catuta0/tpu-e-cpu/reports/fpga/soc/soc_impl.md

# SoC implementation report — soc_top on Tang Nano 9K (task RTL-SOC)

Agent: fpga-engineer · Date: 2026-11-04 · Input revision: ac0f0a0-dirty (spec rev C, ARCHITECTURE.md 12 / INTERFACES.json revision C)
Command (reproducible): `bash scripts/synth_soc.sh` (both flows, 3 seeds each, ~45 min single-thread);
`REPORT_ONLY=1 bash scripts/synth_soc.sh` rebuilds the tables/pins/pack from the logs.
Tools: Yosys 0.70 (YoWASP), nextpnr-0.11.1 himbaechel-gowin (YoWASP), Apicula 0.32 (gowin_pack).
Device GW1NR-LV9QN88PC6/I5, `--vopt family=GW1N-9C`, CST `design/constraints/tangnano9k.cst`, `--freq 27`,
`--threads 1`, **no** `--timing-allow-fail`. Logs: `logs/soc/synth_<flow>.log`, `logs/soc/pnr_<flow>_s<seed>.log`.

**Label: every number below is SIMULATION (tool estimate of synthesis / static timing), not a
hardware measurement. Passing P&R is not hardware validation; the nextpnr Gowin timing model is not
validated against silicon. The bitstream was never programmed into a device.**

## Design synthesised
`design/rtl/soc/soc_top.v` = rv32i_core (design/rtl/cpu, unchanged) + soc_bus + soc_ram (4 KiB, INIT
`sim/data/soc_demo_prog.hex`) + soc_periph (LED, UART TX 234 clk/bit, CYCLE, TOHOST) + sc_tpu (NL 16, IL 8,
RNG_MODE 2, rev C seeds, INIT `sim/data/weights.hex`, `bias.hex`, `input.hex`), 2-FF reset synchroniser,
active-low LED inversion. Ports exactly INTERFACES.json `top_ports`.

Yosys cell list, chosen flow (`synth_gowin -nowidelut`, logs/soc/synth_nwl.log `stat`):
LUT1 12, LUT2 518, LUT3 1486, LUT4 1508, ALU 1642, DFF 235, DFFE 1088, DFFR 117, DFFRE 1119, DFFS 2, DFFSE 146,
RAM16SDP4 16, SDPX9B 3, SPX9 2, IBUF 3, OBUF 7. Yosys `check`: "Found and reported 0 problems" (4 x, both
flows), 0 latches inferred (REQ-TIM-002).

BSRAM mapping (routed netlist, logs/soc/bsram_init.log): 5 blocks = soc_ram 2 x SP (4 KiB program/data,
non-zero INIT = program image), sc_tpu weight RAM 1 x SDP (non-zero INIT = weights.hex), CPU register file
2 x SDP (all-zero INIT, cleared by the CPU CLEAR state). INPUT/BIAS buffers: 16 RAM16SDP4 (LUT RAM, as in
RTL-TPU). DSP blocks: 0 (REQ-RES-003).

## Utilisation and timing per flow (from the nextpnr "Device utilisation" block and the LAST "Max frequency" line)
<!-- generated by scripts/synth_soc.sh from logs/soc/, input revision ac0f0a0-dirty -->

### Flow `nwl`: synth_gowin -nowidelut (chosen)

| Resource | device total | 85 % limit | seed 1 | seed 2 | seed 3 | worst % | <= 85 % |
|---|---|---|---|---|---|---|---|
| LUT4 | 8640 | 7344 | 5628 (65 %) | 5628 (65 %) | 5628 (65 %) | 65 % | PASS |
| ALU | 6480 | 5508 | 1976 (30 %) | 1976 (30 %) | 1976 (30 %) | 30 % | PASS |
| DFF | 6480 | 5508 | 2803 (43 %) | 2803 (43 %) | 2803 (43 %) | 43 % | PASS |
| BSRAM | 26 | 22 | 5 (19 %) | 5 (19 %) | 5 (19 %) | 19 % | PASS |
| RAM16SDP4 | 270 | 229 | 16 (5 %) | 16 (5 %) | 16 (5 %) | 5 % | PASS |
| IOB | 276 | 234 | 10 (3 %) | 10 (3 %) | 10 (3 %) | 3 % | PASS |
| MUX2_LUT5 | 4320 | 3672 | 0 (0 %) | 0 (0 %) | 0 (0 %) | 0 % | PASS |
| MULT18X18 | 20 | 17 | 0 (0 %) | 0 (0 %) | 0 (0 %) | 0 % | PASS |

(nextpnr counts every ALU cell inside LUT4 as well; LUT4 is the total of logic positions used.)

| Seed | P&R exit | post-route Fmax (MHz) | margin vs 27 MHz | >= 29.7 MHz |
|---|---|---|---|---|
| 1 | 0 | 51.98 | +92.5 % | PASS |
| 2 | 0 | 47.46 | +75.8 % | PASS |
| 3 | 0 | 51.21 | +89.7 % | PASS |

Worst seed 2: 47.46 MHz (clock `u_bus.clk`); worst utilisation of any resource 65 %.

### Flow `def`: synth_gowin default wide-LUT (comparison)

| Resource | device total | 85 % limit | seed 1 | seed 2 | seed 3 | worst % | <= 85 % |
|---|---|---|---|---|---|---|---|
| LUT4 | 8640 | 7344 | 6130 (70 %) | 6130 (70 %) | 6130 (70 %) | 70 % | PASS |
| ALU | 6480 | 5508 | 1976 (30 %) | 1976 (30 %) | 1976 (30 %) | 30 % | PASS |
| DFF | 6480 | 5508 | 2803 (43 %) | 2803 (43 %) | 2803 (43 %) | 43 % | PASS |
| BSRAM | 26 | 22 | 5 (19 %) | 5 (19 %) | 5 (19 %) | 19 % | PASS |
| RAM16SDP4 | 270 | 229 | 16 (5 %) | 16 (5 %) | 16 (5 %) | 5 % | PASS |
| IOB | 276 | 234 | 10 (3 %) | 10 (3 %) | 10 (3 %) | 3 % | PASS |
| MUX2_LUT5 | 4320 | 3672 | 710 (16 %) | 710 (16 %) | 710 (16 %) | 16 % | PASS |
| MUX2_LUT6 | 2160 | 1836 | 138 (6 %) | 138 (6 %) | 138 (6 %) | 6 % | PASS |
| MUX2_LUT7 | 1080 | 918 | 49 (4 %) | 49 (4 %) | 49 (4 %) | 4 % | PASS |
| MUX2_LUT8 | 1080 | 918 | 18 (1 %) | 18 (1 %) | 18 (1 %) | 1 % | PASS |
| MULT18X18 | 20 | 17 | 0 (0 %) | 0 (0 %) | 0 (0 %) | 0 % | PASS |

(nextpnr counts every ALU cell inside LUT4 as well; LUT4 is the total of logic positions used.)

| Seed | P&R exit | post-route Fmax (MHz) | margin vs 27 MHz | >= 29.7 MHz |
|---|---|---|---|---|
| 1 | 0 | 46.47 | +72.1 % | PASS |
| 2 | 0 | 45.79 | +69.6 % | PASS |
| 3 | 0 | 42.8 | +58.5 % | PASS |

Worst seed 3: 42.8 MHz (clock `u_bus.clk`); worst utilisation of any resource 70 %.

### Acceptance (ARCHITECTURE.md 10: each resource <= 85 %, worst-seed Fmax >= 29.7 MHz)
| Item | Chosen flow `nwl` | Result |
|---|---|---|
| Worst resource utilisation | 65 % (LUT4 5628 / 8640) | PASS (<= 85 %) |
| DFF | 2803 / 6480 = 43 % | PASS |
| BSRAM | 5 / 26 = 19 % | PASS |
| IOB | 10 / 276 (all 10 top-level IOs) | PASS (REQ-RES-005: 10) |
| DSP (MULT*) | 0 | PASS |
| Worst-seed post-route Fmax | 47.46 MHz (seed 2); seeds 51.98 / 47.46 / 51.21 | PASS (>= 29.7 MHz; +75.8 % vs 27 MHz, +59.8 % vs 29.7 MHz, CALCULATION) |

Flow comparison (CALCULATION from the tables): `-nowidelut` uses 502 fewer LUT4 positions (5628 vs 6130),
no MUX2_LUTx cells (vs 915) and its worst seed is 4.66 MHz faster (47.46 vs 42.80 MHz). `-nowidelut` is kept.
Against the stand-alone blocks: TPU IL8 mode 2 nwl 4572 LUT4 / 2669 DFF (RTL-TPU) + CPU in-context 957 LUT4 /
126 DFF (RTL-CPU) = 5529 / 2795; the SoC is 5628 / 2803, i.e. +99 LUT4 / +8 DFF for bus, peripherals and UART
(CALCULATION; the CPU number included its own small wrapper, so this is approximate).

## Critical path (chosen flow, worst seed 2, post-route) — reports/fpga/soc/critical_path_nwl.txt
21.07 ns = 8.83 ns logic + 12.24 ns routing (=> 47.46 MHz). Inside the CPU: instruction register
`u_cpu.ir` -> decoder / FSM next-state logic (`u_cpu.state`) -> ALU operand select -> 32-bit ALU carry chain
(`u_cpu.alu_q` ALU cells) -> program-counter register (`cpu_dbg_pc` = pc, D input). This is the same class of
path as in RTL-CPU (ir -> decoder -> FSM, 18.77 ns there); the TPU datapath (53-77 MHz alone) is not critical
in the SoC. The default flow's worst path (seed 3, 23.36 ns = 9.73 + 13.63) is the same CPU path ending on the
pc clock enable (critical_path_def.txt). The 10 % margin target needs <= 33.67 ns; slack 12.6 ns.

## Pin placement (worst seed 2 of `nwl`, scripts/pnr_pin_report.py, logs/soc/pins.log)
| Port | Bel | IO | Package pin | IO standard |
|---|---|---|---|---|
| clk | X46Y16/IOBA | IOR17A (GCLKT_3) | 52 | LVCMOS33, pull-up |
| btn_rst_n | X1Y0/IOBA | IOT2A | 3 | LVCMOS18, pull-up |
| led_n[0..5] | X0Y14..X0Y25 | IOL15A, IOL16B, IOL21B, IOL22B, IOL25B, IOL26B | 10, 11, 13, 14, 15, 16 | LVCMOS18 |
| uart_tx | X1Y28/IOBA | IOB2A | 17 | LVCMOS33, pull-up |
| uart_rx | X1Y28/IOBB | IOB2B | 18 | LVCMOS33, pull-up |

All 10 ports placed on the CST pins (script checks every pin, `NIO = 10`). The only "not found" Infos in the
P&R logs are the documented spare `btn_s2_n` and the 26 GW1NR in-package PSRAM pins. uart_rx is unused
(INTERFACES.json) and kept by a `(* keep *)` net so that its IOB and constraint remain.

## Bitstream (route proof only — NEVER programmed)
`gowin_pack -d GW1N-9C -o sim/soc/build/soc_top.fs sim/soc/build/soc_top_nwl_pnr_s2.json` -> PACK_EXIT=0,
3 556 680 bytes (uncompressed ASCII .fs; larger than the 2.07 MB smoke bitstream because the BSRAM init data is
included), sha256 `152d3c6dada6338e0b98a8fc19557ec95f4e40479e4f264411c72caa85b76258` (logs/soc/pack.log).
The file is a build product (sim/soc/build/, gitignored); rebuild with `bash scripts/synth_soc.sh`.

## Not done / limits
- Gate-level (post-synthesis / post-route) simulation: NOT RUN (no behavioural Gowin BSRAM models in
  yowasp-yosys; see RTL-CPU lesson).
- Hardware test: NOT RUN (no hardware programming in this project).
- Timing is single-corner nextpnr STA of the Gowin chip database; no I/O timing constraints (the only
  external interfaces are a button, LEDs and a 115200 Bd UART, all asynchronous / slow).
