catuta0/tpu-e-cpu/management/RESUME.md

# Resume
To resume after a restart: `claude --continue`, then run the engineering-project
skill again; it reads this file. Named agents in .claude/agents/ will then load
natively (see ADR-000).
Current position: see PROJECT_STATE.md and TASK_BOARD.md.
