catuta0/tpu-e-cpu/reports/article/main.tex

% =============================================================================
% DOC-02 -- Scientific article, revision for design rev C (IEEEtran conference).
% Project: SC-TPU + RV32I SoC on the Sipeed Tang Nano 9K (GW1NR-9).
% Author of this file: documentation-engineer.
% Input revision: git fab802e (branch claude/awesome-lovelace-hu02o8); HEAD moved
% to 99ee941 during the task, which changes only management/EXECUTION_METRICS.md
% and scripts/make_release.sh (no evidence file).  Design state: spec rev C
% (design/architecture/ARCHITECTURE.md sec. 12, management/INTERFACES.json
% revision C, management/DECISIONS.md ADR-008..012).
% History: DOC-01 (rev A draft, input eee3352) -> DOC-02 (this file, rev C).
%
% Build:  cd reports/article && latexmk -pdf -interaction=nonstopmode \
%                                        -halt-on-error main.tex
% Figures: vector PDFs generated by reports/figures/article_figures.py from
%          reports/sw/accuracy_revC.json and reports/sw/revABC_comparison.json
%          (log: logs/doc/article_figures_revC.log); block/timing diagrams are
%          TikZ (this file).
%
% Number policy (CLAUDE.md, engineering-evidence skill):
%   * every number carries a "% evidence: <path>" comment on or next to its line;
%   * labels used in the text: SIMULATION, CALCULATION, SOURCE, ASSUMPTION;
%     no MEASUREMENT exists in this project (no hardware was operated);
%   * synthesis / place-and-route / static-timing numbers are tool estimates
%     and are labelled SIMULATION in the project sense.
%
% REVIEW HOOK: the independent review (reports/review/REVIEW_A_cpu_soc.md,
% reports/review/REVIEW_B_tpu_model_article.md, task REV-01) was running when
% this revision was written.  Its findings are NOT reflected yet; search for
% "REVIEW-FINDINGS-HOOK" below for the place where they are to be summarised.
% =============================================================================
\documentclass[conference]{IEEEtran}

\usepackage[T1]{fontenc}
\usepackage{amsmath,amssymb}
\usepackage{graphicx}
\usepackage{cite}
\usepackage{booktabs}
\usepackage{multirow}
\usepackage{xcolor}
\usepackage{tikz}
\usetikzlibrary{positioning,arrows.meta,calc,fit,decorations.pathreplacing}
\usepackage{url}
\usepackage[hidelinks]{hyperref}

% Figures generated by scripts in reports/figures/.
\graphicspath{{../figures/}}

% -----------------------------------------------------------------------------
% Placeholder macro kept from DOC-01 for future use (prints a red [TBD:name]).
% DOC-02 filled every numeric placeholder; it is no longer used in the text.
% -----------------------------------------------------------------------------
\newcommand{\TBD}[1]{\textcolor{red}{\textbf{[TBD:\detokenize{#1}]}}}

% Small helpers for consistent notation.
\newcommand{\Dp}{D'}                 % post-processed accumulator (spec: Dp)
\newcommand{\NL}{N_{L}}              % neuron lanes
\newcommand{\IL}{N_{I}}              % input lanes
\newcommand{\lbl}[1]{\textsc{#1}}    % evidence label in running text

\begin{document}

\title{A Stochastic-Computing Tensor Unit and an RV32I Core on a 9K-LUT FPGA:\\
Bit-Exact Co-Design for Tiny-MLP Inference}

% Author names and affiliation have not been provided by the user: placeholders.
\author{\IEEEauthorblockN{Author Name}
\IEEEauthorblockA{Affiliation (placeholder)}}

\maketitle

% =============================================================================
\begin{abstract}
Stochastic computing (SC) replaces a multiplier by a single logic gate acting
on random bit-streams, which makes it attractive for the smallest FPGAs, where
dedicated multipliers are scarce. We present the co-design of an SC tensor
processing unit (SC-TPU) and a multi-cycle RV32I processor for an 8640-LUT4
Gowin GW1NR-9 device (Sipeed Tang Nano 9K). The SC-TPU is a 16$\times$8
weight-stationary tile of bipolar XNOR multipliers with accumulative parallel
counters, driven by 8-step leap-forward LFSRs. Its behaviour, including the
random-number sequence and the integer post-processing, is specified
bit-exactly, so that a Python golden model, the training flow and the RTL must
agree bit for bit; in simulation they do on 1454 inferences. For a 64-16-10 MLP
on the 8$\times$8 digits set the golden model gives 95.0\,\% test accuracy for
the expected-value datapath and 94.4\,\% (95\,\% CI 91.6--96.4\,\%) for SC with
independent per-lane generators at stream length 256 (92.8$\pm$1.4\,\% over 20
seed offsets). A seed revision that maximised the phase spacing of the
generators made the operand-pair streams of different lanes time-translates
of each other and lost 4.7 percentage points at stream length 512 (McNemar
$p=0.0015$); we derive two seed rules that exclude this and select seeds on
validation data. The integrated SoC uses 65\,\% of the LUT4 positions and
closes timing at 47.46\,MHz (worst of three seeds) against the 27\,MHz board
clock; one inference takes 2928 cycles (108\,\textmu s). All results are
simulations with an open-source flow; a bitstream was generated but never
loaded into a device.
% evidence: logs/tpu/sim_tpu_console.log (1454 golden inferences = 474+506+474, 0 mismatching fields)
% evidence: reports/sw/accuracy_revC.json (EV 342/360; mode2 K8 340/360 CI 91.6-96.4; ensemble mean 92.8 sd 1.4, n_realisations 20)
% evidence: reports/sw/revABC_comparison.md sec. 2 (C vs B, K=9: +4.7 pp, McNemar exact p = 0.00151)
% evidence: reports/fpga/soc/soc_impl.md (LUT4 5628/8640 = 65 %, worst seed 47.46 MHz); logs/soc/tb_soc_demo.log (D6 CYCLES 2928)
% evidence: requirements/BUDGETS.md sec. 3 (2928 cycles = 108.44 us at 27 MHz, CALCULATION); logs/soc/pack.log (bitstream, never programmed)
\end{abstract}

\begin{IEEEkeywords}
stochastic computing, neural network accelerator, RISC-V, FPGA, LFSR seeding,
bit-exact golden model, open-source FPGA toolchain
\end{IEEEkeywords}

% =============================================================================
\section{Introduction}
\label{sec:intro}

Low-cost FPGAs with fewer than ten thousand look-up tables are widely used in
education, prototyping and small embedded products, but they offer only a
handful of hard multipliers. The GW1NR-9 device used here has 8640 LUT4
positions, 6480 flip-flops, 26 block RAMs and 20 18$\times$18
multipliers~\cite{sipeed_tn9k}.
% evidence: management/SOURCES.md S-001, S-002, S-005, S-010 (SOURCE, Sipeed wiki D-09 + chip database D-20)
A binary int8 neural-network datapath on such a device is limited to at most
40 hard 9$\times$9 multiply--accumulate (MAC) lanes, or must spend roughly 70
LUTs per soft 8$\times$8 multiplier (rough \lbl{calculation}).
% evidence: management/DECISIONS.md ADR-001 option B (~70 LUT soft multiplier, rough CALCULATION); management/SOURCES.md S-032 (40 MULT9X9, SOURCE D-20)

Stochastic computing~\cite{gaines1969,alaghi2013survey} encodes a number as the
probability of a one in a random bit-stream. A multiplication then reduces to
a single AND (unipolar) or XNOR (bipolar) gate, and the precision becomes a
run-time parameter: doubling the stream length $L$ halves the variance of the
result. Neural networks tolerate moderate arithmetic noise, which has made them
a prominent application of SC~\cite{brown2001stochastic,%
kim2016dynamic,ren2017scdcnn}. The price is latency ($L$ clock cycles per
product), the cost of random-number generation, and a sensitivity to
correlation between streams.

A second, less discussed difficulty is \emph{verification}: an SC result is a
random variable, so a hardware/software comparison is meaningless unless the
random sequence is defined as precisely as the arithmetic. This paper treats
the random-number generators, their seeding and their sequencing as part of a
bit-exact architectural contract, and shows that the seeds themselves are a
design parameter that needs its own rules and its own held-out evaluation.

\textbf{Contributions.}
\begin{enumerate}
\item A complete, small SoC for the Tang Nano 9K: a multi-cycle
  RV32I CPU~\cite{riscv2019unpriv} orchestrating a 16$\times$8 weight-stationary
  bipolar SC tile with accumulative parallel counters (APC), implemented with
  an open-source flow~\cite{shah2019yosysnextpnr,yosys,apicula}
  (Section~\ref{sec:arch}).
\item A bit-exact specification of the SC datapath (8-step leap-forward LFSR,
  three RNG decorrelation modes, integer post-processing), mirrored by a
  Python golden model used for noise-aware training and matched by the RTL
  in simulation (Section~\ref{sec:method}).
\item An accuracy study versus stream length and RNG mode with confidence
  intervals and a 20-offset seed ensemble, and an analytical variance model
  checked against simulation (Section~\ref{sec:results}).
\item A documented design iteration on the LFSR seeds, including a negative
  result: phase-maximal seeds are \emph{worse}; two seed rules and a
  pre-registered selection protocol replace them (Section~\ref{sec:iteration}).
\end{enumerate}

% =============================================================================
\section{Background and Related Work}
\label{sec:background}

\subsection{Stochastic number encoding}
A stochastic number (SN) is a bit-stream $b_0,\dots,b_{L-1}$. In
\emph{unipolar} encoding it represents $p=P(b_k{=}1)\in[0,1]$; in
\emph{bipolar} encoding it represents $v = 2p-1 \in[-1,1]$, which admits signed
weights with a single stream per operand~\cite{gaines1969,alaghi2013survey}.
A stochastic number generator (SNG) converts a binary code $c$ into a stream by
comparing it with a pseudo-random number $r$: $b=[r<c]$. With $r$ uniform on
$\{0,\dots,2^n-1\}$, $P(b{=}1)=c/2^n$.

\subsection{Multiplication and accumulation}
For two independent unipolar streams the AND gate gives $P(a\wedge b)=p_ap_b$.
For bipolar streams the XNOR gate gives
\begin{equation}
  P\big(\overline{a\oplus b}=1\big) = \tfrac{1}{2}\left(1 + v_a v_b\right),
  \label{eq:xnor}
\end{equation}
i.e.\ the bipolar product~\cite{brown2001stochastic,alaghi2013survey}.
Accumulating many products with a multiplexer scales the sum down by the fan-in
and loses precision. An accumulative parallel counter instead counts the ones
of all product streams in each cycle and adds the count to a binary
accumulator, so the sum is exact in expectation and leaves the stochastic
domain; SC-DCNN~\cite{ren2017scdcnn} studied such APC-based inner products for
deep convolutional networks. Kim \emph{et al.}~\cite{kim2016dynamic} exploited
the stream length as a run-time energy--accuracy knob in deep networks.

\subsection{Precision, correlation and LFSRs}
An $L$-bit estimate of $p$ has variance $p(1-p)/L$, so every factor of four in
$L$ adds one bit of precision. Equation~\eqref{eq:xnor} holds only for
independent streams; streams generated from the same or from shifted random
sequences are correlated and bias or inflate the error~\cite{alaghi2013survey}.
Linear-feedback shift registers (LFSRs) are the usual cheap random source.
Taking $n$ consecutive bits of a single-step LFSR as $r$ yields successive
values that are shifted copies of each other, and two LFSRs with the same
polynomial produce lagged copies of the same maximal-length sequence. Both
effects matter in a small design that cannot afford many independent
generators.

\subsection{Small RISC-V cores and open FPGA flows}
PicoRV32~\cite{wolf_picorv32} is a size-optimised RV32 core with the same
native valid/ready memory interface that we adopt. The Yosys and nextpnr
tools~\cite{shah2019yosysnextpnr,yosys}, together with the reverse-engineered
Gowin database of Project Apicula~\cite{apicula}, provide a fully open flow for
the GW1N family; we use it exclusively.

% =============================================================================
\section{Architecture}
\label{sec:arch}

\subsection{SoC overview}
Fig.~\ref{fig:soc} shows the SoC. A single 27\,MHz clock domain is driven by
the board oscillator (no PLL); the reset button passes through a two-flip-flop
synchroniser into a synchronous active-high reset.
% evidence: design/architecture/ARCHITECTURE.md sec. 2; management/INTERFACES.json "clock"
The CPU is the only bus master. Slaves are selected by address bits [31:28]
(Table~\ref{tab:memmap}); an access to an unmapped region returns zero,
completes normally and sets a sticky debug flag, so a software error can never
hang the bus. The bus is a native valid/ready protocol: the master holds
\texttt{mem\_valid}, address, data and byte strobes stable until the slave
returns a one-cycle \texttt{mem\_ready} pulse. RAM and peripherals answer in
the second cycle, the SC-TPU in the third; a TPU read of its buffers while the
controller owns their ports waits for up to 35 cycles (\lbl{simulation}).
% evidence: design/architecture/ARCHITECTURE.md sec. 3, 4; management/handoffs/fpga-engineer/RTL-SOC.md (design summary: 1 wait state RAM/periph, TPU 3rd cycle); RTL-TPU.md (longest valid->ready 35 cycles); management/DECISIONS.md ADR-012 (<= 40 cycles allowed)

\begin{figure}[!t]
\centering
\begin{tikzpicture}[
    font=\scriptsize,
    blk/.style={draw, thick, rounded corners=1pt, align=center,
                minimum height=0.8cm, inner sep=2pt},
    sub/.style={draw, align=center, minimum height=0.62cm, inner sep=1.5pt,
                minimum width=1.75cm},
    >={Stealth[length=1.5mm]}]
  % ---- CPU (only bus master) -------------------------------------------
  \node[blk, minimum width=2.2cm] (cpu) at (1.1,0.35)
       {RV32I multi-cycle\\CPU (FSM)};
  \node[draw, align=center, minimum width=2.2cm, inner sep=1.5pt,
        below=0.05cm of cpu] (rf) {regfile in 2 BSRAM};
  \draw[<-] (cpu.north) -- ++(0,0.3) node[above]
       {27\,MHz clk, rst (2-FF sync)};
  % ---- Bus ----------------------------------------------------------------
  \draw[line width=1.6pt] (2.7,1.2) -- (2.7,-1.75);
  \node[anchor=south west, font=\tiny, inner sep=1pt] at (2.7,1.2) {valid/ready bus};
  \draw[<->, thick] (cpu.east) -- (2.7,0.35);
  % ---- RAM and peripherals ---------------------------------------------
  \node[blk, minimum width=2.75cm, anchor=west] (ram) at (3.1,0.8)
       {RAM 4\,KiB (BSRAM)\quad\texttt{0x0}};
  \node[blk, minimum width=2.75cm, anchor=west] (per) at (3.1,-0.3)
       {LED, UART TX, CYCLE,\\TOHOST \texttt{0x1000\_0000}};
  \draw[<->, thick] (2.7,0.8) -- (ram.west);
  \draw[<->, thick] (2.7,-0.3) -- (per.west);
  \draw[->] (per.east) -- ++(0.3,0) node[right, align=left]
       {6 LEDs\\UART TX};
  % ---- SC-TPU -------------------------------------------------------------
  \draw[thick, dashed, rounded corners=2pt] (-0.05,-1.2) rectangle (7.2,-3.95);
  \node[anchor=south east, font=\scriptsize\bfseries, align=right] at (7.15,-3.9)
       {SC-TPU\\\texttt{0x2000\_0000}};
  \node[sub, anchor=west] (regs) at (3.1,-1.75)
       {CTRL, STATUS,\\CONFIG, PARAMS};
  \node[sub, anchor=west] (bufs) at (5.1,-2.65)
       {INPUT, HIDDEN,\\SCORE, BIAS};
  \node[sub, anchor=west] (wram) at (3.1,-2.65)
       {weight RAM\\2\,KiB BSRAM};
  \node[sub, anchor=west] (ctl) at (3.1,-3.5)
       {controller FSM\\tile/layer counters};
  \draw[<->, thick] (2.7,-1.75) -- (regs.west);
  \node[sub, anchor=west] (lfsr) at (0.1,-1.75) {16 LFSRs, 8-step leap\\(RNG mode 2)};
  \node[sub, anchor=west, fill=black!7, minimum height=0.75cm] (arr)
       at (0.1,-2.65) {16$\times$8 SC tile\\XNOR + APC};
  \node[sub, anchor=west] (pp) at (0.1,-3.5) {post-processing\\+ argmax};
  \draw[->] (lfsr) -- (arr);
  \draw[->] (arr) -- (pp);
  \draw[->] (wram.west) -- node[above, font=\tiny]{tile load} (arr.east);
  \draw[->] (pp.east) -- (ctl.west);
\end{tikzpicture}
\caption{SoC block diagram (architecture specification rev~C). The CPU is the
only bus master; the SC-TPU is a memory-mapped slave whose weight RAM is
time-shared between CPU accesses and tile loads.}
\label{fig:soc}
\end{figure}

\begin{table}[!t]
\centering
\caption{Memory map (spec rev C, \lbl{source}: architecture specification)}
\label{tab:memmap}
% evidence: design/architecture/ARCHITECTURE.md sec. 4, 4.1, 5.4; management/INTERFACES.json revision C
\footnotesize
\setlength{\tabcolsep}{2.2pt}
\begin{tabular}{@{}lll@{}}
\toprule
Base & Size & Content \\
\midrule
\texttt{0x0000\_0000} & 4\,KiB & RAM (program + data), reset PC $=0$ \\
\texttt{0x1000\_0000} & 32\,B & LED, UART\_TX/STATUS, CYCLE, TOHOST \\
\texttt{0x2000\_0000} & 4\,KiB & SC-TPU: registers \texttt{0x000}--\texttt{0x017}, \\
 & & INPUT \texttt{0x040}, SCORE \texttt{0x080}, HIDDEN \texttt{0x0C0}, \\
 & & BIAS \texttt{0x100}, weight RAM \texttt{0x800}--\texttt{0xFFF} \\
other & -- & read 0, write ignored, sticky \texttt{bus\_err} \\
\bottomrule
\end{tabular}
\end{table}

\subsection{RV32I multi-cycle CPU}
The CPU implements the RV32I base instruction set~\cite{riscv2019unpriv} with
FENCE as a no-op; there are no CSRs and no interrupts. ECALL, EBREAK, illegal
encodings (strictly decoded, including all CSR instructions, unknown
funct3/funct7 values, \texttt{0x00000000} and \texttt{0xFFFFFFFF}) and
misaligned accesses or jump targets halt the core with one of six trap
causes. Because the CPU only orchestrates the accelerator, it is optimised for
area:
% evidence: design/architecture/ARCHITECTURE.md sec. 6, 9; management/DECISIONS.md ADR-004, ADR-006
\begin{itemize}
\item a state machine with the states CLEAR, FETCH, DECODE, EXECUTE,
  SHIFT or MEM, and WB; CLEAR zeroes the 32 registers once after reset
  (32 cycles), so the first fetch follows 31 cycles after reset release
  (\lbl{simulation});
\item the register file is held in two block RAMs (one per read port), costing
  no LUT or flip-flop for its 1\,kbit of state;
\item a single 33-bit adder serves arithmetic, comparisons and address
  generation; branch targets are computed in DECODE so that the comparison in
  EXECUTE can reuse it;
\item shifts are iterative (4 or 1 bit per cycle) instead of a barrel shifter.
\end{itemize}
% evidence: management/handoffs/fpga-engineer/RTL-SOC.md (tb_soc R5: first fetch 31 cycles after rst falls); management/DECISIONS.md ADR-011
The resulting cycles per instruction at zero wait states are
(\lbl{calculation} from the FSM): 3 for LUI, AUIPC, JAL, FENCE and branches,
4 for ALU operations, JALR and stores, 5 for loads, and
$4+\lfloor n/4\rfloor+(n \bmod 4)$ for a shift by $n$.
% evidence: management/handoffs/fpga-engineer/RTL-CPU.md (micro-architecture summary); design/rtl/cpu/rv32i_core.v header

\subsection{SC-TPU dataflow}
The workload is a 64-16-10 multilayer perceptron with a clipped-ReLU hidden
layer and an argmax output. Every input, activation and weight is an 8-bit
code $c$ representing the bipolar value $v(c)=(c-128)/128\in[-1,127/128]$.
% evidence: design/architecture/ARCHITECTURE.md sec. 5.1, 5.2
The array is a weight-stationary tile of $\NL=16$ neuron lanes by $\IL=8$ input
lanes (Fig.~\ref{fig:tile}). $\NL=16$ equals the hidden width, so one pass of
a layer-1 tile serves all hidden neurons. Layer~1 is processed in
$T=64/8=8$ tiles and layer~2 in $T=16/8=2$ tiles; the six unused neuron lanes
of layer~2 are padding and are ignored by the argmax.
% evidence: design/architecture/ARCHITECTURE.md sec. 5.3, 5.5; management/DECISIONS.md ADR-002
A fully parallel layer-1 array (1024 lanes, 8192 weight flip-flops) does not
fit the 6480 flip-flops of the device, which fixed the tile choice.
% evidence: management/DECISIONS.md ADR-002 (CALCULATION); management/SOURCES.md S-002

For one tile the 128 weights $W_{ji}$ and the 8 input codes $x_i$ are loaded
into registers; then, during $L=2^K$ stream cycles $k$, every neuron lane
updates its APC accumulator
\begin{equation}
  \mathit{acc}_j \leftarrow \mathit{acc}_j + \sum_{i=0}^{\IL-1}
  \overline{[r_x(i,k)<x_i] \oplus [r_w(j,i,k)<W_{ji}]} .
  \label{eq:acc}
\end{equation}
The accumulators are cleared once per layer and keep running over its tiles,
so after the last tile $\mathit{acc}_j$ is the count of ones of the complete
dot product.
% evidence: design/architecture/ARCHITECTURE.md sec. 5.3 step 1a-1b

\begin{figure}[!t]
\centering
\begin{tikzpicture}[
    font=\scriptsize,
    box/.style={draw, align=center, minimum height=0.5cm, inner sep=1.5pt},
    gate/.style={draw, circle, inner sep=0.5pt, minimum size=0.45cm},
    >={Stealth[length=1.4mm]}]
  % Random number sources
  \node[box, minimum width=1.25cm] (lx) at (-0.2,0.9) {LFSR$_{X,i}$\\16b, 8 steps};
  \node[box, minimum width=1.25cm] (lw) at (-0.2,-0.9) {LFSR$_{W,i}$\\16b, 8 steps};
  % Comparators of lane (j,i)
  \node[box] (cx) at (2.2,0.9) {$r_x<x_i$};
  \node[box] (cw) at (2.2,-0.9) {$r_w<W_{ji}$};
  \node[box, minimum width=0.9cm] (xr) at (2.2,1.75) {$x_i$ reg};
  \node[box, minimum width=0.9cm] (wr) at (2.2,-1.75) {$W_{ji}$ reg};
  \draw[->] (lx) -- node[above]{$r_x$ (8b)} (cx);
  \draw[->] (lw) -- node[below]{$r_w$ (8b)} (cw);
  \draw[->] (xr) -- (cx);
  \draw[->] (wr) -- (cw);
  % XNOR
  \node[gate] (xn) at (3.55,0) {$\overline{\oplus}$};
  \draw[->] (cx.east) -| (xn.north);
  \draw[->] (cw.east) -| (xn.south);
  % Popcount and accumulator
  \node[box, minimum width=1.15cm, minimum height=1.1cm] (pc) at (4.85,0)
       {popcount\\over $\IL{=}8$\\lanes};
  \draw[->] (xn) -- node[above]{$p_{ji}$} (pc);
  \node[font=\tiny, align=center] at (4.85,-0.85) {7 other lanes\\of neuron $j$};
  \draw[->] (4.85,-0.65) -- (pc.south);
  \node[box, minimum width=0.95cm, minimum height=1.1cm] (acc) at (6.4,0)
       {$+$\\$\mathit{acc}_j$\\17b};
  \draw[->] (pc) -- node[above]{0..8} (acc);
  \draw[->] (acc.east) -- ++(0.35,0) node[right, align=left]{post-\\proc};
  % Replication brace
  \draw[decorate, decoration={brace, amplitude=3pt}]
       (1.55,2.15) -- (4.1,2.15) node[midway, above=2pt]
       {one MAC lane $(j,i)$, replicated $16\times 8$};
\end{tikzpicture}
\caption{One MAC lane of the SC tile and the APC of neuron $j$. The input
comparator $[r_x<x_i]$ is shared by the 16 neuron lanes; every weight has its
own comparator. In the default RNG mode 2 each input lane $i$ has its own
LFSR pair, shared by the 16 neuron lanes; modes 0/1 use one pair for all lanes.}
\label{fig:tile}
\end{figure}

\subsection{Leap-forward LFSR and RNG modes}
All generators are 16-bit Fibonacci LFSRs with the polynomial
$x^{16}+x^{14}+x^{13}+x^{11}+1$ (period 65535, maximal, \lbl{calculation}).
% evidence: design/architecture/ARCHITECTURE.md sec. 5.3; requirements/BUDGETS.md sec. 9.1 (scripts/budgets/logs/lfsr_check.log)
To avoid the shifted-copy correlation of consecutive single-step outputs, each
stream cycle advances every LFSR by \emph{eight} steps and uses the low byte of
the new state as $r$ (ADR-005). Each of the eight new bits is the XOR of four
current-state bits, so the leap costs eight LUT4s and one logic level per LFSR
(\lbl{calculation}); the RTL registers the state one stream cycle ahead, so
$r$ is a flip-flop output.
% evidence: requirements/BUDGETS.md sec. 1.2 (8-step leap-forward); management/DECISIONS.md ADR-005; management/handoffs/fpga-engineer/RTL-TPU.md (look-ahead LFSR)
The golden model verifies the unrolled network against eight single steps for
all 65536 states, and the RTL testbench does so for 70\,000 cycles.
% evidence: management/handoffs/software-engineer/SW-01a.md (test_leap8_equals_8_single_steps_for_all_states); logs/tpu/tb_sc_lfsr8.log ("TC2 LEAP==8x1 70000 cycles, 0 mismatches")

Three RNG modes are a synthesis parameter (ADR-003):
\begin{itemize}
\item \emph{Mode 0 (shared)}: one LFSR$_X$ (seed \texttt{0xACE1}) for all
  input lanes and one LFSR$_W$ (seed \texttt{0xF9DE}, half a period later)
  for all weight lanes.
\item \emph{Mode 1 (rotate)}: the same two LFSRs, lane $i$ uses
  $\mathrm{rotl}_8(r,i)$, a free re-wiring.
\item \emph{Mode 2 (independent, default)}: one LFSR pair per input lane,
  seeds $(\texttt{0xACE1}+\texttt{0x3C5A}\,i)\bmod 2^{16}$ and
  $(\texttt{0x7A5C}+\texttt{0x2B67}\,i)\bmod 2^{16}$, shared by the 16 neuron
  lanes.
\end{itemize}
% evidence: design/architecture/ARCHITECTURE.md sec. 12 (rev C seeds; 0xF9DE = S(32768)); management/INTERFACES.json revision C tpu.lfsr
The LFSRs are loaded with their seeds when START is accepted, advance only in
stream cycles and are not reset between tiles or layers. In the RTL, mode 2
costs 111 LUT4 and 224 flip-flops (14 additional 16-bit LFSRs) more than mode~1
(\lbl{simulation} of synthesis and place-and-route). Mode~1 was the default of
the first specification (rev~A); rev~C makes mode~2 the default, with the
seeds chosen as described in Section~\ref{sec:iteration}.
% evidence: reports/fpga/tpu/variants.md (il8_m1_nwl 4461 / 2445 vs il8_m2_nwl 4572 / 2669: +111 LUT4, +224 DFF); management/DECISIONS.md ADR-003, ADR-008, ADR-010

\subsection{Post-processing (bit-exact)}
After the last tile of a layer each neuron $j$ is post-processed with integer
arithmetic exactly as in the specification, with $N_{in}$
the layer fan-in, $K\in\{4,\dots,10\}$ and the activation shift
$s\in\{0,\dots,7\}$:
\begin{align}
  D_j &= 2\,\mathit{acc}_j - N_{in}L, \label{eq:D}\\
  B_j &= \left\lfloor \mathit{bias}_j\, 2^K / 128 \right\rfloor,
  \qquad \Dp_j = D_j + B_j, \label{eq:B}\\
  u_j &= \left\lfloor \Dp_j\, 2^{s+7} / 2^K \right\rfloor, \nonumber\\
  \mathrm{HIDDEN}_j &= 128 + \mathrm{clip}(u_j,0,127), \label{eq:hidden}\\
  \mathrm{SCORE}_j &= \Dp_j \;\text{(signed, 32 bits)}, \label{eq:score}
\end{align}
where \eqref{eq:hidden} applies to layer~1 (hidden codes),
\eqref{eq:score} to layer~2, $\mathit{bias}_j$ is a signed 16-bit integer in
units of $1/128$, and
$\mathrm{RESULT}=\arg\max_{j\in\{0..9\}}\mathrm{SCORE}_j$ with ties resolved to
the lowest index. Since $E[\overline{a\oplus b}]=(1+v_av_b)/2$,
$\Dp_j/L$ is an unbiased estimate of $\sum_i v(x_i)v(W_{ji})+\mathit{bias}_j/128$
up to the floor in $B_j$.
% evidence: design/architecture/ARCHITECTURE.md sec. 5.3 (post-process, interpretation)
The RTL uses a 17-bit accumulator, 20-bit signed $D$, $B$ and $\Dp$, and a
34-bit exact shifter for $\Dp\,2^{s+7}$, in a two-stage pipeline
(\lbl{calculation}, checked on 53\,328 directed vectors in simulation).
% evidence: management/handoffs/fpga-engineer/RTL-TPU.md (widths; tb_sc_postproc "vectors checked = 53328, mismatches = 0"); requirements/BUDGETS.md sec. 1.3

\subsection{Programming model and tile schedule}
Weights and biases are written once through the bus into the weight RAM and the
BIAS buffer (or pre-loaded from initialisation files in the bitstream). Per
inference the CPU writes the 64 input codes (16 words), sets LOG2\_L and
ACT\_SHIFT in CONFIG, writes START, polls STATUS.DONE and reads RESULT; the
CYCLES register reports the busy time.
% evidence: design/architecture/ARCHITECTURE.md sec. 5.4, 5.6, 8
Fig.~\ref{fig:timing} shows the tile schedule of the RTL controller. A tile
load reads the 32 weight words from the block RAM in 32 consecutive cycles
plus one cycle of read latency; the two input words are read in the same
cycles. $L$ stream cycles follow. After the last tile of a layer, 19 cycles
($\NL+3$) read the biases, run the two-stage post-processing pipeline and
update the argmax on the fly.
% evidence: design/rtl/tpu/sc_tpu_ctrl.v header (FSM S_LOAD NWT+1 = 33, S_STREAM 2^K, S_POST NL+3 = 19)

\begin{figure}[!t]
\centering
\resizebox{\columnwidth}{!}{%
\begin{tikzpicture}[font=\scriptsize, >={Stealth[length=1.3mm]},
    seg/.style={draw, minimum height=0.36cm, inner sep=0pt, anchor=west,
                align=center}]
  % Signal names
  \foreach \y/\n in {0/state, -0.6/wram\_rd, -1.2/stream\_en, -1.8/acc\_clr}
    \node[anchor=east] at (-0.1,\y) {\texttt{\n}};
  % State bar (not to scale)
  \node[seg, minimum width=1.5cm, fill=black!8, font=\tiny] at (0,0) {LOAD W+X};
  \node[seg, minimum width=2.6cm, font=\tiny] at (1.5,0) {STREAM ($L=2^K$)};
  \node[seg, minimum width=1.0cm, fill=black!8, font=\tiny] at (4.1,0) {LOAD};
  \node[seg, minimum width=0.6cm, font=\tiny] at (5.1,0) {\dots};
  \node[seg, minimum width=1.1cm, fill=black!15, font=\tiny] at (5.7,0) {POST};
  % wram_rd high during LOAD
  \draw (0,-0.75) -- (0,-0.45) -- (1.5,-0.45) -- (1.5,-0.75) -- (4.1,-0.75)
        -- (4.1,-0.45) -- (5.1,-0.45) -- (5.1,-0.75) -- (6.8,-0.75);
  % stream_en high during STREAM (LFSR advance + APC accumulate)
  \draw (0,-1.35) -- (1.5,-1.35) -- (1.5,-1.05) -- (4.1,-1.05)
        -- (4.1,-1.35) -- (5.1,-1.35) -- (5.1,-1.05) -- (5.7,-1.05)
        -- (5.7,-1.35) -- (6.8,-1.35);
  % acc_clr pulse at layer start (tile 0, first load cycle)
  \draw (-0.0,-1.95) -- (0,-1.65) -- (0.15,-1.65) -- (0.15,-1.95) -- (6.8,-1.95);
  % Durations
  \draw[<->] (0,-2.35) -- node[below]{$32{+}1$} (1.5,-2.35);
  \draw[<->] (1.5,-2.35) -- node[below]{$2^K$} (4.1,-2.35);
  \draw[<->] (5.7,-2.35) -- node[below]{$\NL{+}3=19$} (6.8,-2.35);
  \node[anchor=west, align=left] at (0,-2.95)
       {tile $t$ \hspace{3.1cm} tile $t{+}1$ \dots\ last tile, then layer post-processing};
\end{tikzpicture}}
\caption{Tile schedule of the RTL controller (durations in clock cycles; not
to scale). The LFSRs advance only while \texttt{stream\_en} is high. Ten tiles
and two post-processing phases give $\mathrm{CYCLES}=10(2^K+33)+2\cdot19$
(\lbl{calculation}, confirmed by \lbl{simulation} for $K=4..10$).}
% evidence: design/rtl/tpu/sc_tpu_ctrl.v header; logs/tpu/tb_sc_tpu_mode2.log (D8 "CYCLES = 2928 = measured BUSY cycles 2928 = formula 10*2^8+368"); management/handoffs/fpga-engineer/RTL-TPU.md (TPU-014 every K)
\label{fig:timing}
\end{figure}

% =============================================================================
\section{Co-Design and Verification Methodology}
\label{sec:method}

\subsection{Bit-exact golden model}
The Python golden model implements the specification twice: a literal
reference with explicit loops and eight single LFSR steps per stream cycle,
and a vectorised engine that pre-computes, per tile and lane, a count table
from the histogram of $(r_x,r_w)$ pairs, which makes the accuracy sweeps fast.
All 593 exported test vectors (33 fields each: hidden codes, scores, result)
were regenerated by the slow reference with 0 mismatches
(\lbl{simulation}); 158 unit tests pass.
% evidence: logs/sw/gen_hex.log ("CROSSCHECK TOTAL: 593 vectors x 33 fields, mismatches = 0"); logs/sw/pytest_revC.log ("158 passed")
For the RTL the model exports, per RNG mode, the 360 test images at $K=8$,
51 corner-case parameter sets, 63 sweep vectors ($K=4..10$,
$s\in\{0,3,7\}$) and cycle-by-cycle RNG traces. Every vector file carries a
specification-revision header that the simulation scripts check. The RTL
testbench compares all hidden codes, scores, RESULT and CYCLES of 1454
inferences over the three modes, plus 239 re-runs with out-of-range LOG2\_L
values, with 0 mismatching fields, and the per-lane random numbers of the
first 64 stream cycles after every START with 0 mismatches
(\lbl{simulation}, Icarus Verilog 12.0~\cite{icarus}).
% evidence: logs/tpu/sim_tpu_console.log (mode 2: "golden vectors total 474 (+69 clamp re-runs), mismatching inferences 0, mismatching fields 0"; R1/R2 RNG trace 0 mismatches; spec_rev guard); management/handoffs/fpga-engineer/RTL-SOC.md (1454 + 239, rev C)

\subsection{Training with SC noise}
The data set is the 8$\times$8 handwritten-digits set distributed with
scikit-learn~\cite{pedregosa2011sklearn,uci_digits} (1797 images, pixels
0..16). A stratified split gives 1437 training and 360 test images; 288 of the
training images form a validation split used for every model choice and for
the seed selection, and the test split is used only for the final numbers.
Pixels map to codes $c=128+\lfloor(127p+8)/16\rfloor$, i.e.\ non-negative
bipolar values.
% evidence: reports/sw/accuracy_revC.json "split", "dataset"; code/python/sctpu/train.py pixel_to_code
Three variants were trained (Adam, 300 epochs, straight-through estimator for
the code rounding): \emph{float} (rounded after training), \emph{qat}
(quantisation-aware) and \emph{qat\_noise}, which adds zero-mean Gaussian noise
with the independent-stream variance of~\eqref{eq:var3} at $K=8$ to both
layers' pre-activations during training. The selected model is qat\_noise with
$s=0$, chosen on the validation split; the final weights were then re-trained
on all 1437 training images. The network was not re-trained for the later
seed revisions.
% evidence: management/handoffs/software-engineer/SW-01a.md (assumptions, selected model); SW-03.md ("Not retrained"; caveat: re-trained on all 1437 training images); reports/sw/accuracy_revC.json selected_variant, selected_s, retrained = False

\subsection{Analytical error model}
Writing each stream bit as a spin $\sigma=2b-1$ and assuming uniform,
cycle-independent $r$ and independent X and W generators, the variance of the
estimate $\Dp/L$ of one neuron is (\lbl{calculation})
\begin{equation}
  \mathrm{Var}\!\left(\frac{\Dp}{L}\right) = \frac{1}{L}\sum_{\text{tiles}}
  \Big[\sum_{i,k} C^{x}_{ik} C^{w}_{ik} - \Big(\sum_i v_{x,i} v_{w,i}\Big)^2\Big],
  \label{eq:var2}
\end{equation}
where $C_{ik}$ is the spin correlation of lanes $i$ and $k$ within a tile
($C_{ii}=1$). With shared numbers (mode 0) $C_{ik}=1-2|a-b|/256$ for codes $a,b$;
mode 1 is enumerated exactly over the 256 values of $r$; for independent lanes
(mode 2) it reduces to
\begin{equation}
  \mathrm{Var}\!\left(\Dp/L\right) = \frac{1}{L}\sum_i \left(1 - v_{x,i}^2
  v_{w,i}^2\right).
  \label{eq:var3}
\end{equation}
% evidence: reports/sw/error_model.md eqs. (1)-(3)
The variance is largest for zero products; since most digit pixels are blank
(code 128), layer~1 operates close to its worst case $64/L$. Sharing random
numbers makes lanes with similar codes almost perfectly correlated and can
multiply the variance by up to $\IL=8$.

\subsection{CPU verification by ISS-based differential testing}
CPU stimuli are produced by a Python reference assembler and checked on a
Python instruction-set simulator (ISS); they are testbench stimuli, not
firmware. The suite has 44 programs: 11 directed, 20 random (200-instruction
bodies, recorded seeds) and 13 trap tests covering every trap cause. Each
program ends by dumping all registers into a 32-word signature. The ISS and
assembler are covered by unit tests, including an assemble/disassemble round
trip over 48\,502 seeded instruction words with 0 mismatches.
% evidence: management/handoffs/software-engineer/SW-01b.md; logs/sw/pytest_rv32.log; reports/sw/cpu_tests_summary.json
The self-checking RTL testbench runs every program under four bus timings
(0, 1 and 3 wait states, and random 0--7 cycle stalls) and compares the
signature, stop kind, trap cause, halt PC, retired-instruction count, TOHOST
value, bus-error flag, LED and UART output with the ISS. A bus-protocol checker
enforces seven rules (stable requests while waiting, no ready without valid,
no X/Z, aligned fetches, exact byte strobes, one data access per instruction,
silence after halt). The 44 programs are run again on the integrated SoC.
% evidence: management/handoffs/fpga-engineer/RTL-CPU.md (checks, protocol checker rules P1-P7); logs/soc/cpu_suite_summary.log ("44 / 44 PASS")

\subsection{Checking the checkers}
A passing testbench proves little unless it can fail. Each RTL testbench is
therefore re-run with an injected fault and must report failure with a
non-zero exit code: a wrong reference model in the TPU unit testbenches
(LFSR tap, truncating instead of floor division, AND instead of XNOR), a
flipped bit in an expected score (TPU and SoC), a corrupted expected CPU
signature, a bus request that changes while waiting for
\texttt{mem\_ready}, a \texttt{mem\_ready} without request, a wrong UART
divider (240 instead of 234 clocks per bit) and an inverted LED polarity. All
ten negative runs fail as required (\lbl{simulation}). These are faults in
the checkers, references and stimuli, not a systematic mutation campaign of
the RTL.
% evidence: logs/tpu/*_inject_fault.log (4 x TEST FAILED); logs/cpu/sim_cpu_summary.log ("sig fault -> TEST FAILED ... proto fault -> TEST FAILED"); logs/soc/sim_soc_console.log (4 negative runs "TEST FAILED as required")

\subsection{Open-source implementation flow}
Synthesis uses Yosys~0.70 with the Gowin script and wide-function
multiplexers disabled (\texttt{-nowidelut}, chosen because it gave 502 fewer
LUT4 positions and a 4.66\,MHz faster worst seed on the SoC); placement and
routing use nextpnr-0.11.1 (himbaechel back end, family GW1N-9C, 27\,MHz
constraint), and the bitstream is packed with Apicula~0.32 only as a proof of
routability; it was never programmed into a device. Simulation uses Icarus
Verilog 12.0~\cite{icarus} and lint Verilator 5.020~\cite{verilator}.
% evidence: reports/fpga/soc/soc_impl.md (flow comparison, tools); management/DECISIONS.md ADR-011; management/TOOLCHAIN.md
Each design is placed and routed with three seeds and the \emph{worst}
post-route Fmax is reported. The acceptance targets are Fmax $\ge 29.7$\,MHz
(27\,MHz + 10\,\%) and at most 85\,\% of each device resource.
% evidence: design/architecture/ARCHITECTURE.md sec. 10 (rev A.2 margins)

% =============================================================================
\section{Results}
\label{sec:results}
All results in this section are \lbl{simulation} (golden model, RTL
simulation or static timing analysis of the place-and-route result) or
\lbl{calculation}; none is a hardware measurement.

\subsection{Accuracy versus stream length and RNG mode}
Fig.~\ref{fig:acc} and Table~\ref{tab:acc} give the test accuracy of the
bit-exact model with the deployed rev~C seeds and, as a check that one seed
set is not a lucky or unlucky draw, the mean over 20 analysis-only LFSR start
offsets (all generators advanced by a common random number of steps, which
keeps their relative lags). The reference is the expected-value (EV) model, in
which every stream is replaced by its expectation: 95.0\,\% (342/360, CI
92.2--96.8\,\%). An exact int8 binary datapath on the same codes gives the
identical result (0 mismatches in hidden codes, scores and results), so it
serves as the non-SC baseline. A float-trained network evaluated in floating
point reaches 96.1\,\% (346/360).
% evidence: reports/sw/accuracy_revC.json models.qat_noise.expected_value_Kinf, int8_binary, int8_vs_ev_mismatches_hidden_score_result = 0, float_trained_at_hw_s (346/360); rng_seeds_of_study.ensemble_size = 20

\begin{figure}[!t]
\centering

\caption{Test accuracy ($n=360$) of the bit-exact model versus $K$ for the
three RNG modes (\lbl{simulation}). (a) Deployed rev~C seeds with 95\,\% Wilson
intervals~\cite{wilson1927}; (b) mean $\pm$ one standard deviation over 20
LFSR start offsets. Grey: EV model with its 95\,\% interval. Data:
\texttt{reports/sw/accuracy\_revC.json}.}
% evidence: reports/sw/accuracy_revC.json; generator reports/figures/article_figures.py; log logs/doc/article_figures_revC.log
\label{fig:acc}
\end{figure}

\begin{table*}[!t]
\centering
\caption{Test accuracy [\%] versus $K$ (\lbl{simulation}, golden model,
selected model qat\_noise, $s=0$, $n=360$). HW: deployed rev~C seeds, correct
count $k$ and 95\,\% Wilson CI; Ens.: mean $\pm$ s.d.\ over 20 LFSR start
offsets. EV ($K\to\infty$): 95.0 (342/360, CI 92.2--96.8).}
\label{tab:acc}
% evidence: reports/sw/accuracy_revC.json models.qat_noise.sc and .sc_ensemble_accuracy (printed in logs/doc/article_figures_revC.log)
\setlength{\tabcolsep}{4.2pt}
\begin{tabular}{@{}c|ccc|ccc|ccc@{}}
\toprule
 & \multicolumn{3}{c|}{Mode 0 (shared)} & \multicolumn{3}{c|}{Mode 1 (rotate)} & \multicolumn{3}{c}{Mode 2 (independent, default)}\\
$K$ & HW ($k$) & CI & Ens. & HW ($k$) & CI & Ens. & HW ($k$) & CI & Ens.\\
\midrule
4  & 48.3 (174) & 43.2--53.5 & 40.2$\pm$17.5 & 60.8 (219) & 55.7--65.7 & 55.6$\pm$13.4 & 45.3 (163) & 40.2--50.4 & 60.3$\pm$13.1\\
5  & 40.8 (147) & 35.9--46.0 & 52.1$\pm$20.4 & 77.2 (278) & 72.6--81.3 & 71.8$\pm$10.7 & 75.3 (271) & 70.6--79.5 & 71.0$\pm$10.2\\
6  & 61.7 (222) & 56.5--66.5 & 71.2$\pm$16.0 & 81.7 (294) & 77.3--85.3 & 83.7$\pm$4.2 & 89.2 (321) & 85.5--92.0 & 83.0$\pm$5.2\\
7  & 89.7 (323) & 86.2--92.5 & 87.5$\pm$4.9 & 90.0 (324) & 86.5--92.7 & 89.8$\pm$2.3 & 88.9 (320) & 85.2--91.7 & 90.7$\pm$1.7\\
8  & 81.9 (295) & 77.6--85.6 & 90.7$\pm$4.4 & 89.2 (321) & 85.5--92.0 & 92.8$\pm$1.3 & 94.4 (340) & 91.6--96.4 & 92.8$\pm$1.4\\
9  & 90.0 (324) & 86.5--92.7 & 93.5$\pm$1.1 & 94.4 (340) & 91.6--96.4 & 94.3$\pm$0.8 & 94.4 (340) & 91.6--96.4 & 94.4$\pm$0.5\\
10 & 94.2 (339) & 91.2--96.2 & 94.5$\pm$0.7 & 95.0 (342) & 92.2--96.8 & 95.3$\pm$0.5 & 95.3 (343) & 92.6--97.0 & 94.8$\pm$0.5\\
\bottomrule
\end{tabular}
\end{table*}

Four observations follow. First, at the reset default $K=8$ ($L=256$) the
deployed seeds give 81.9, 89.2 and 94.4\,\% for modes 0, 1 and 2, but the
ensemble means are 90.7, 92.8 and 92.8\,\%: much of the spread between the
modes at a fixed seed set is realisation noise, and modes 1 and 2 have the
same mean at $K=8$. Second, shared numbers (mode~0) are clearly worse in both
mean and spread: the ensemble standard deviation at $K=8$ is 4.4\,pp against
1.3--1.4\,pp, and the deployed-seed accuracy is non-monotonic in $K$
(89.7\,\% at $K=7$, 81.9\,\% at $K=8$), because with one generator pair all
images see the same few empirical $(r_x,r_w)$ histograms. Third, mode~2
has the smallest seed-to-seed spread at $K=9$ (0.5\,pp versus 0.8 and
1.1\,pp).
Fourth, as a design rule, the smallest $K$ at which the deployed-seed accuracy
stays within 1 and 2 percentage points (pp) of EV for every larger $K$ is
10/9/8 for modes 0/1/2 (both thresholds); with the ensemble mean it is 10/9/9
within 1\,pp and 9/9/9 within 2\,pp. The release design therefore runs mode~2
at $K=8$.
% evidence: reports/sw/accuracy_revC.json design_rule, design_rule_ensemble_mean, sc, sc_ensemble_accuracy; reports/sw/revABC_comparison.md sec. 4
One percentage point corresponds to 3.6 images, below the 95\,\% CI
half-width of 2.3--3.1\,pp for accuracies between 95 and 90\,\%; in particular
the 2-image gap between mode~2 at $K=8$ (340/360) and EV (342/360) is not
statistically resolved, and the design rule is an engineering choice.
% evidence: reports/sw/accuracy_revC.json ci95 (mode2 K8: 91.6-96.4); requirements/BUDGETS.md sec. 8
Noise-aware training did not change the $s=0$ result significantly (mode~2,
$K=8$: 95.3\,\% for qat versus 94.4\,\% for qat\_noise), but post-training
rounding of a float-trained model did not come within 1\,pp of EV for any
$K\le10$.
% evidence: reports/sw/accuracy_revC.json models.qat.sc["2"]["8"] = 343/360; models.float.design_rule (1 pp: None for all modes)

\subsection{Error model versus simulation}
Fig.~\ref{fig:rms} compares the RMS error of $\Dp/L$ (deterministic bias term
removed) with~\eqref{eq:var2}. Over the 20-offset ensemble the ratio of
measured to predicted RMS lies within 0.77--1.05 for all 42
layer/$K$/mode combinations; for mode~2 it lies within 0.90--1.05. The
prediction tracks the $1/\sqrt{L}$ law and the penalty of mode~0 (at $K=8$,
layer~1: 0.70 measured, 0.79 predicted, versus 0.49/0.48 for mode~2). A single
deployed-seed realisation can deviate much more, e.g.\ mode~0, layer~2,
$K=8$: 0.42 measured against 0.19 predicted.
% evidence: reports/sw/accuracy_revC.json error_study.per_mode_K (ensemble_ratio min 0.773 mode0 K7 L1, max 1.050 mode1 K5 L2; printed in logs/doc/article_figures_revC.log); reports/sw/error_model.md (rev C addendum)
The model treats different stream cycles as independent. All LFSRs, however,
run on the same maximal-length sequence: with the 8-step leap, two generators
whose seeds are $d$ single steps apart produce the same numbers with a lag of
$d\cdot 8^{-1} \bmod 65535$ stream cycles. For the rev~C mode-2 seeds the
smallest such lag is 321 cycles (X$_0$/W$_3$), i.e.\ inside one layer from
$K=6$; such a lag couples only one operand of two products, and the
ensemble agreement above indicates that its effect is small. No LFSR state
repeats within an inference (at most 10\,240 stream cycles), but the
underlying bit sequence wraps after 8192 stream cycles, so at $K=10$ a
generator re-uses its own random numbers shifted by one bit; the $K=10$
accuracy shows no penalty (\lbl{calculation}).
% evidence: reports/sw/accuracy_revC.json lfsr_lags (min 321 X0-W3, cycles_per_inference K10 = 10240); requirements/BUDGETS.md sec. 9.1 (issue-2 correction: bit-sequence wrap after 8192 stream cycles, 7 of 8 bits shared)

\begin{figure}[!t]
\centering

\caption{RMS stochastic error of $\Dp/L$ per neuron versus $K$
(\lbl{simulation} and \lbl{calculation}): 20-offset ensemble (filled),
prediction~\eqref{eq:var2} (lines) and the single deployed rev~C
realisation (open). Layer 2 uses the SC hidden codes of the same run.}
% evidence: reports/sw/accuracy_revC.json error_study; generator reports/figures/article_figures.py
\label{fig:rms}
\end{figure}

\subsection{\texorpdfstring{Design iteration on the seeds: A $\rightarrow$ B $\rightarrow$ C}{Design iteration on the seeds: A to B to C}}
\label{sec:iteration}
The first specification (rev~A) defined the mode-2 seeds by the arithmetic
progressions above without a structural argument. Because the lag analysis
showed generators only 321 stream cycles apart, rev~B re-derived them as
maximally phase-spaced points of the common sequence,
$X_i=S(4096\,i)$ and $W_i=S(32768+4096\,i)$ with $S(n)$ the state $n$ single
steps after \texttt{0xACE1}: any two of the 16 generators are then at least
512 stream cycles apart.
% evidence: design/architecture/ARCHITECTURE.md sec. 11 (rev B); management/DECISIONS.md ADR-008
This was a mistake. Since X$_i$ and W$_i$ advance by the \emph{same} 4096
steps from lane to lane, the operand-pair stream $(r_x,r_w)$ of lane $i$ is
that of lane $i{-}1$ delayed by 512 stream cycles. For $K\le9$ this is a whole
number of tiles, so identical XNOR count tables recur in different
(tile, lane) slots (14, 54, 120, 196 and 100 slot pairs out of 3160 at
$K=6..10$; none for rev~A), and their errors add coherently instead of
averaging. Fig.~\ref{fig:revbc} shows the consequence: at $K=9$ mode~2
falls to 89.7\,\% (323/360) against 94.4\,\% (340/360), with 22 images
correct only with the rev~C seeds and 5 only with rev~B (exact McNemar
test~\cite{mcnemar1947}, $p=0.0015$; difference $+4.7$\,pp, Newcombe 95\,\%
interval~\cite{newcombe1998} $+2.0$ to $+7.8$\,pp). The measured layer-1
error exceeds~\eqref{eq:var2} by 30\,\% and 55\,\% at $K=9$ and 10.
% evidence: reports/sw/revABC_comparison.md sec. 2 (C vs B K=9: 89.7 (323) / 94.4 (340), discordant 5/22, p = 0.00151, Newcombe [+2.0, +7.8]) and sec. 5 (identical pairs, RMS ratios 1.30 / 1.55); reports/sw/error_model.md (rev B addendum, 3160 slot pairs); management/DECISIONS.md ADR-009

\begin{figure}[!t]
\centering

\caption{Mode-2 seed iteration (\lbl{simulation}, $n=360$). (a) Deployed-seed
accuracy with 95\,\% Wilson intervals, dashed: EV. (b) Layer-1 ensemble RMS
error relative to eq.~\eqref{eq:var2}; numbers: identical count-table pairs
of rev~B (rev~C: 0 at every $K$). Data:
\texttt{reports/sw/revABC\_comparison.json}.}
% evidence: reports/sw/revABC_comparison.json per_rev.B/C["2"]; generator reports/figures/article_figures.py; log logs/doc/article_figures_revC.log
\label{fig:revbc}
\end{figure}

The general requirement is not spacing but the absence of shared structure
between the operand pairs of different lanes. With $D_i$ the phase offset
(in single steps) between W$_i$ and X$_i$, we use two rules:
\textbf{R1}, no two lanes' operand-pair streams are translates of each other
($D_i\neq D_j$ for $i\neq j$), and the stricter \textbf{R2}, no lane pair
shares bits in both operands at a common lag, directly or swapped
($|D_i-D_j|>14$ and $|D_i+D_j|>14$, circularly; the window of $\pm14$ steps
arises because $r$ is an 8-bit window of one bit sequence). Rev~B violates R1
on all 28 lane pairs.
% evidence: requirements/REQUIREMENTS.md (Conventions: seed rules R1/R2); reports/sw/seed_selection_revC.md sec. 1; requirements/BUDGETS.md sec. 9.2 (independent check: rev B R1 violated 28 of 28)
To select the rev~C seeds without touching the test split, a protocol was
fixed in advance: five candidates (C0 = rev~A, C1 = rev~B, C2 = rev~B with the
W lanes reversed, which satisfies R1 but not R2, and C3/C4 obtained by an
exhaustive scan for the largest lags under R1 and R2) are evaluated on the
288 validation images, and the highest worst-case deployed accuracy over
$K\in\{8,9,10\}$ wins. The ranking was C0 98.96\,\%, C3 98.26\,\%, C4
97.22\,\%, C2 95.83\,\%, C1 95.14\,\%. These images were part of the final
training set, so the absolute values are optimistic and only the ranking is
used; moreover C0, C3 and C4, which all satisfy R1 and R2, are not
significantly different (paired McNemar $p\ge0.125$). The candidates that
violate a rule are the two worst. Rev~C therefore restores the rev~A mode-2
seeds, which also carry the longest RTL verification history, now justified
by an explicit rule and held-out evidence rather than by accident; on the
test split rev~C equals rev~A in mode~2 image by image.
% evidence: reports/sw/seed_selection_revC.md sec. 1-2 (worst-case 285/283/280/276/274 of 288; McNemar C0 vs C3/C4 all p >= 0.125; caveat); management/DECISIONS.md ADR-010; reports/sw/revABC_comparison.md (identity C = A in mode 2 asserted bit-exactly)

\subsection{Latency and throughput}
The RTL controller of Fig.~\ref{fig:timing} needs
\begin{equation}
  \mathrm{CYCLES}(K) = 10\cdot 2^K + 368 \;\text{clock cycles}
  \label{eq:latency}
\end{equation}
per inference: ten tiles of $2^K+33$ cycles and two post-processing phases of
19 cycles (\lbl{calculation}). The testbenches confirm it for every
$K=4..10$ and every vector (CYCLES register = counted busy cycles = formula,
\lbl{simulation}). The pre-RTL budget, $10\cdot2^K+409$, had assumed 36 load
cycles per tile and separate argmax and handshake cycles; the requirement
allows at most 1.10 times the budget, i.e.\ 3265 cycles at $K=8$.
% evidence: design/rtl/tpu/sc_tpu_ctrl.v header; management/handoffs/fpga-engineer/RTL-TPU.md (TPU-014); requirements/BUDGETS.md sec. 3; requirements/REQUIREMENTS.md REQ-TIM-004
Table~\ref{tab:latency} pairs the latency with the accuracy of
Table~\ref{tab:acc}. At $K=8$ an inference takes 2928 cycles or
108.4\,\textmu s at 27\,MHz (9221 inferences/s, $1.09\times10^7$ network
MAC/s).
% evidence: requirements/BUDGETS.md sec. 3 table and sec. 4 (achieved columns, CALCULATION from SIMULATION cycles)
On the integrated SoC the demonstration program, with weights, biases and one
input image pre-loaded from the initialisation files, needs 2948 cycles from
the START store to the RESULT load (CYCLES plus 20 cycles of polling and
handshake) and 5441 cycles (201.5\,\textmu s) from reset release to
completion, 981 instructions in total. The time for writing the 64 input codes
was not simulated because this program does not write them.
% evidence: logs/soc/tb_soc_demo.log (INFO end-to-end line; instructions retired 981); management/DECISIONS.md ADR-011 (REQ-TIM-005 PARTIAL)

\begin{table}[!t]
\centering
\caption{Inference latency: pre-RTL budget (\lbl{calculation}) and RTL
CYCLES (\lbl{simulation}, eq.~\eqref{eq:latency}) at 27\,MHz, with the
deployed rev~C accuracy (\lbl{simulation})}
\label{tab:latency}
% evidence: requirements/BUDGETS.md sec. 3 (budget and achieved columns); reports/sw/accuracy_revC.json (accuracy modes 1 / 2)
\setlength{\tabcolsep}{3.2pt}
\begin{tabular}{@{}rrrrrrr@{}}
\toprule
$K$ & $L$ & budget & RTL & time [\textmu s] & inf./s & acc. m1 / m2 [\%]\\
\midrule
4  & 16   & 569   & 528   & 19.56  & 51\,136 & 60.8 / 45.3\\
6  & 64   & 1049  & 1008  & 37.33  & 26\,786 & 81.7 / 89.2\\
8  & 256  & 2969  & 2928  & 108.44 & 9\,221  & 89.2 / 94.4\\
10 & 1024 & 10649 & 10608 & 392.89 & 2\,545  & 95.0 / 95.3\\
\bottomrule
\end{tabular}
\end{table}

\subsection{CPU results}
All 44 programs pass under all four bus timings (176/176 runs) with zero
protocol violations, and both injected faults are detected
(\lbl{simulation}, Icarus Verilog 12.0). The aggregate CPI over the suite is
4.231 at zero wait states (28\,206 cycles for 6667 instructions), 5.593 with
one wait state (the block-RAM slave of the SoC), 8.317 with three and 9.013
with random stalls. Placed and routed alone with the 4\,KiB RAM, the core
closes at 62.46, 53.26 and 55.74\,MHz for seeds 1--3 (\lbl{simulation},
static timing analysis). The core maps to 831 LUTs, 74 carry cells, 111
flip-flops and two block RAMs; with the RAM and wrapper it occupies 957 of
8640 LUT4 positions (11\,\%). A first version with a barrel shifter needed
1212 LUT4 positions plus 463 wide-function multiplexers in the same context,
which motivated the iterative shifter.
% evidence: logs/cpu/sim_cpu_summary.log; management/handoffs/fpga-engineer/RTL-CPU.md (CPI ws1/ws3/rand, barrel shifter); logs/cpu/pnr_s1.log, pnr_s2.log, pnr_s3.log; reports/fpga/cpu/cpu_synth_pnr.txt

\subsection{Resources and timing}
Table~\ref{tab:res} collects the implementation figures. Before the RTL
existed, a calibration benchmark of one 16$\times$8 tile was synthesised and
routed to size the design; the bottom-up SoC budget built on it was 5735 LUT4
(66.4\,\%) and 2489 flip-flops (\lbl{calculation}).
% evidence: requirements/BUDGETS.md sec. 1.2, 1.4
The integrated SoC needs 5628 LUT4 positions (65\,\%), 2803 flip-flops
(43\,\%), 5 of 26 block RAMs (program RAM 2, weight RAM 1, CPU register file
2) and no hard multiplier; every resource stays below the 85\,\% limit. The
total matches the budget within 2\,\% only by compensation: the TPU came out
20\,\% larger and the CPU 51\,\% smaller than budgeted.
% evidence: reports/fpga/soc/soc_impl.md (nwl flow, BSRAM mapping, DSP 0); requirements/BUDGETS.md sec. 0 (-1.9 %, TPU +20 %, CPU -51 %)
The worst of three seeds closes at 47.46\,MHz (51.98, 47.46 and 51.21\,MHz),
59.8\,\% above the 29.7\,MHz target. The critical path (21.07\,ns, of which
12.24\,ns routing) is not the SC datapath, as the budget had predicted, but
the CPU: instruction register, decoder and next-state logic, ALU operand
selection, the 32-bit carry chain and the program counter. The SC-TPU alone
reaches 60.43\,MHz.
% evidence: reports/fpga/soc/soc_impl.md (Fmax per seed, critical path); reports/fpga/soc/critical_path_nwl.txt; requirements/BUDGETS.md sec. 5 (P3 vs P1); reports/fpga/tpu/variants.md (il8_m2_nwl worst 60.43 MHz)
Of the geometry variants, $\IL=4$ fits easily but needs 1.9 times the cycles (5498 at $K=8$), while
$\IL=16$ (73--77\,\% LUT4, carry-heavy) found no legal placement on any
attempted seed, which shows that the practical placement limit for such a
design can lie below the 85\,\% rule.
% evidence: reports/fpga/tpu/variants.md (il4_m1 5498 cycles at K=8; il16_m1 "Unable to find legal placement"); management/RISKS.md R-05

\begin{table*}[!t]
\centering
\caption{Resources (GW1NR-9: 8640 LUT4, 6480 FF, 26 BSRAM) and worst-seed
Fmax (\lbl{simulation}: synthesis, place-and-route and static timing; three
seeds unless noted). LUT4 counts include carry cells and LUT-RAM positions.
Flow \texttt{-nowidelut} unless noted.}
\label{tab:res}
% evidence: requirements/BUDGETS.md sec. 1.1 (device totals SOURCE S-027/S-028/S-031; counting rule), 1.2 (bench), 1.4 (budget)
% evidence: reports/fpga/cpu/cpu_synth_pnr.txt (CPU in context; worst seed 53.26 MHz)
% evidence: reports/fpga/tpu/variants.md (TPU variants; rev A RTL, synthesis-only wrapper ~100 LUT/FF included)
% evidence: reports/fpga/soc/soc_impl.md (SoC rev C, both flows)
\setlength{\tabcolsep}{5pt}
\begin{tabular}{@{}lrrrrl@{}}
\toprule
Block & LUT4 & FF & BSRAM & Fmax [MHz] & Basis\\
\midrule
CPU + 4\,KiB RAM & 957 & 126 & 4 & 53.26 & RTL, stand-alone wrapper\\
SC tile bench, mode 1 / mode 2 & 2855 / 2967 & 1454 / 1678 & 0 & 52.12 / 52.98 & pre-RTL calibration bench\\
SoC budget & 5735 & 2489 & 3 & -- & \lbl{calculation} (bottom-up, mode 1)\\
\midrule
SC-TPU, $\IL=8$, mode 2 & 4572 & 2669 & 1 & 60.43 & RTL, stand-alone wrapper$^{a}$\\
SC-TPU, $\IL=4$, mode 1 & 3542 & 1901 & 1 & 65.30 & RTL variant$^{a}$\\
SC-TPU, $\IL=16$, mode 1 & 6322 & 3533 & 1 & no placement & RTL variant$^{a}$ (1 seed)\\
\midrule
\textbf{SoC, rev C} & \textbf{5628} & \textbf{2803} & \textbf{5} & \textbf{47.46} & release build\\
SoC, rev C, default flow & 6130 & 2803 & 5 & 42.80 & flow comparison\\
\bottomrule
\multicolumn{6}{@{}l}{\footnotesize $^{a}$ Synthesised from the rev~A RTL: mode-2 seeds identical to rev~C; only the PARAMS version constant and the modes 0/1 W seed differ.}\\
\end{tabular}
\end{table*}

% =============================================================================
\section{Discussion and Limitations}
\label{sec:discussion}

\textbf{SC versus binary arithmetic on this device.} The SC tile provides 128
bit-level MAC lanes without using any of the 20 hard multipliers, and its
precision is chosen at run time through CONFIG. Its throughput, however, is
low: at $K=8$ the rate is $1.09\times10^7$ useful MAC/s, whereas the
40 9$\times$9 multipliers of the device clocked at 27\,MHz could in principle
deliver $1.08\times10^9$ int8 MAC/s (\lbl{calculation}, no such design was
built). On this device SC is therefore a study of area, decorrelation and
verification, not a throughput win; its appeal grows where hard multipliers
are absent or energy per operation dominates, which we have not measured.
% evidence: requirements/BUDGETS.md sec. 4 (achieved 1.09e7 MAC/s at K=8; int8 comparison 40 MULT9X9 x 27 MHz, CALCULATION from S-032)

\textbf{Seeds are a design parameter.} The rev~B episode shows that an
intuitive criterion (maximal phase distance) can be worse than an arbitrary
choice, and that the failure is invisible at the default $K=8$ (93.9 versus
94.4\,\%, McNemar $p=0.79$) and appears only at $K=9$. Seed sets should be
checked against structural rules such as R1/R2, compared at several $K$, and
selected on data that are not used for the final claim. Our validation images
had been seen in training, so the selection is weaker than a truly held-out
one would be.
% evidence: reports/sw/revABC_comparison.md sec. 2 (C vs B K=8: 93.9 vs 94.4, p = 0.791); reports/sw/seed_selection_revC.md (caveat)

\textbf{Simulation only.} No bitstream has been loaded into a device and no
quantity in this paper is a hardware measurement. Fmax values come from the
static timing model of nextpnr, whose Gowin delay data are reverse-engineered
and not validated against silicon; no gate-level simulation was run because
no behavioural models of the Gowin block RAMs are available in the flow. No
power figure is reported: no open power model exists for the GW1N family. A
physical validation plan (LED and UART output after reset, cycle counts,
supply current, reset behaviour) is part of the engineering report but has
not been executed.
% evidence: requirements/BUDGETS.md sec. 5 (timing model not silicon-validated), sec. 6 (power NOT RUN); reports/fpga/soc/soc_impl.md ("Not done / limits"); requirements/REQUIREMENTS.md REQ-VER-009

\textbf{Statistical resolution.} With 360 test images one image is 0.28\,pp
and the 95\,\% interval half-width is 2.3--3.1\,pp for accuracies between 95
and 90\,\%. Differences of 1--2\,pp between modes or between $K=8$ and $K=9$
are not resolved, and the selected operating point should be read as an
engineering choice. Paired tests on the same images (McNemar) resolve larger
effects such as the rev~B defect.
% evidence: requirements/BUDGETS.md sec. 8

\textbf{Workload, interfaces and data sources.} The 64-16-10 MLP on
8$\times$8 digits is a deliberately tiny workload; conclusions about accuracy
versus $K$ may not transfer to larger networks. The demonstration does not
measure the CPU-side cost of loading inputs. The Gowin data sheet and memory
user guide could not be opened during this work; device totals were taken
from the board vendor's documentation and the open-source chip database,
which agree, while the block-RAM organisation and the mapping of the two
board buttons to pins remain assumptions.
% evidence: management/SOURCES.md (access status; S-001..S-005 SOURCE; S-006/S-007, S-022 ASSUMPTION); management/DECISIONS.md ADR-011

\textbf{Independent review.} An independent review of the RTL, the golden
model and this article was in progress when this revision was written; its
findings are not yet reflected here.
% REVIEW-FINDINGS-HOOK: replace this paragraph with a summary of the findings
% of reports/review/REVIEW_A_cpu_soc.md and reports/review/REVIEW_B_tpu_model_article.md
% (task REV-01) and their disposition, when the manager forwards them.

% =============================================================================
\section{Conclusion}
\label{sec:conclusion}
We have specified, modelled, implemented and verified in simulation a
stochastic-computing tensor unit and an RV32I processor for a 9K-LUT FPGA with
a fully open-source flow. Treating the random-number generators as part of a
bit-exact contract made the SC datapath verifiable against a golden model
(0 mismatching fields over 1454 inferences) and exposed the role of
decorrelation and of the seeds themselves: in simulation, independent
per-lane generators reach 94.4\,\% at $L=256$, within the confidence interval
of the 95.0\,\% expected-value accuracy, whereas a phase-maximal seed set lost
4.7\,pp at $L=512$ because it made different lanes' operand-pair streams
time-translates. A closed-form variance model predicts the ensemble error
within a factor 0.77--1.05 and supports the stream-length design rule. The
SoC uses 65\,\% of the device and closes timing at 47.46\,MHz against a
27\,MHz clock. Measurements on hardware remain to be done.
% evidence: logs/tpu/sim_tpu_console.log; reports/sw/accuracy_revC.json; reports/sw/revABC_comparison.md; reports/fpga/soc/soc_impl.md

\bibliographystyle{IEEEtran}
\bibliography{refs}

\end{document}
