catuta0/tpu-e-cpu/reports/figures/smoke_plot.pdf

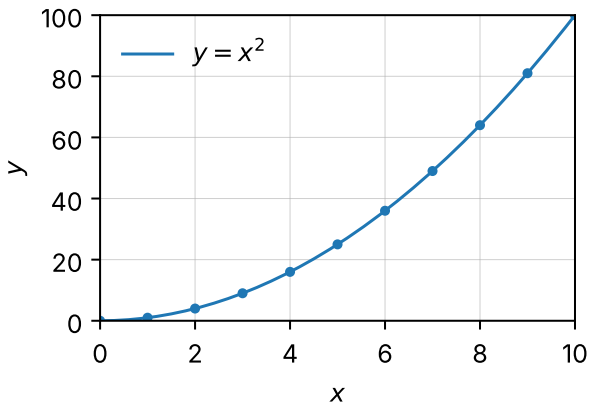
[picture p3: figure]
