catuta0/tpu-e-cpu/reports/engineering/MANUAL.md

# User manual — SC-TPU + RV32I SoC on the Tang Nano 9K (design rev C)

Author: documentation-engineer (task DOC-02) · Date: 2026-11-04 · Input revision: git `fab802e`
(branch `claude/awesome-lovelace-hu02o8`).
Companion documents: engineering report `reports/engineering/main.pdf`, scientific article
`reports/article/main.pdf`.

> **Evidence status.** Every result of this project is a simulation, a calculation or a tool estimate
> (synthesis, place-and-route, static timing). **No hardware was operated.** A bitstream was built as
> a proof of routability and was **never programmed into a board**. Section 5 explains how *you* could
> do that yourself; it is your decision and was not done in the project.

---

## 1. What the system is

A small system-on-chip for the Sipeed Tang Nano 9K (Gowin GW1NR-LV9QN88PC6/I5, 8640 LUT4):

| Block | Summary |
|---|---|
| CPU | RV32I, multi-cycle FSM, no CSRs / interrupts; traps halt the core. Register file in 2 block RAMs. |
| RAM | 4 KiB at `0x0000_0000`, initialised with the demo program. |
| Peripherals | 6 LEDs, UART TX 115200 8N1, free-running cycle counter, TOHOST test mailbox (`0x1000_0000`). |
| SC-TPU | Stochastic-computing tensor unit (`0x2000_0000`): 16x8 weight-stationary tile of XNOR multipliers with accumulative parallel counters, 8-step leap-forward LFSRs, RNG mode 2 (independent per-lane generators). Runs a 64-16-10 MLP for 8x8 digits. Stream length L = 2^K, K = 4..10 (default 8). |
| Clock / reset | One 27 MHz clock (pin 52), no PLL; reset button on pin 3 (assumed to be S1) through a 2-FF synchroniser. |

There is **no firmware**. The only CPU program in the bitstream is the demo stimulus
`sim/data/soc_demo_prog.hex`, generated by `code/python/rv32/gen_soc_demo.py`. It configures the TPU
(K = 8, ACT_SHIFT = 0), starts one inference on the pre-loaded image, waits for DONE, writes RESULT to
the LEDs, sends `'0'+RESULT` and `'\n'` over the UART, stores CYCLES at RAM `0x0E00`, writes TOHOST = 1
and loops forever. For the pre-loaded image (test image 0, label 7) the expected result is class **7**:
LEDs on pins 10, 11 and 13 lit, UART text `7\n` (SIMULATION, `logs/soc/tb_soc_demo.log`).

Headline numbers (all SIMULATION; see the engineering report for labels and evidence):

| Quantity | Value |
|---|---|
| SC accuracy, mode 2, K = 8 (360 test images) | 94.4 % (340/360), 95 % CI 91.6–96.4 % |
| Expected-value / int8 reference | 95.0 % (342/360) |
| RTL vs golden model | 0 mismatching fields over 1454 inferences |
| SoC LUT4 / DFF / BSRAM | 5628 (65 %) / 2803 (43 %) / 5 of 26 |
| Worst-seed Fmax | 47.46 MHz (target ≥ 29.7 MHz) |
| TPU latency at K = 8 | 2928 cycles = 108.4 µs at 27 MHz |

---

## 2. Repository map

| Path | Content |
|---|---|
| `CLAUDE.md` | project rules (evidence labels, status words, no firmware, no hardware flashing) |
| `management/` | project definition, state, task board, `INTERFACES.json` (frozen interfaces, revision C), `DECISIONS.md` (ADR-000..012), `RISKS.md`, `SOURCES.md`, `TOOLCHAIN.md`, `metrics.json`, handoffs of every task (`handoffs/<agent>/<task>.md`) |
| `requirements/` | `REQUIREMENTS.md` (82 requirements, issue 2), `BUDGETS.md` (budgets vs achieved) |
| `design/architecture/ARCHITECTURE.md` | architecture specification; section 12 = rev C (current) |
| `design/rtl/cpu/` | `rv32i_core.v`, `rv32i_decode.v`, `rv32i_alu.v`, `rv32i_regfile.v` |
| `design/rtl/tpu/` | `sc_tpu.v` (bus slave, registers), `sc_tpu_ctrl.v` (FSM), `sc_rng.v` (seed tables), `sc_lfsr8.v`, `sc_lane_array.v`, `sc_postproc.v`, `sc_tpu_synth_top.v` (synthesis-only wrapper) |
| `design/rtl/soc/` | `soc_top.v` (board top), `soc_bus.v`, `soc_ram.v`, `soc_periph.v` |
| `design/constraints/tangnano9k.cst` | pin constraints with cited sources |
| `tests/cpu/`, `tests/tpu/`, `tests/soc/` | self-checking testbenches (each with an `INJECT_FAULT` negative mode) |
| `code/python/sctpu/` | golden model (`model.py`, `lfsr.py`), training (`train.py`), hex export (`gen_hex.py`), accuracy study (`accuracy.py`), seed selection (`seed_select.py`), revision comparisons (`compare_revs.py`, `compare_abc.py`) |
| `code/python/rv32/` | reference assembler, disassembler, ISS, CPU test generator, SoC demo generator |
| `code/python/tests/` | pytest unit tests |
| `sim/data/` | golden data: `weights.hex`, `bias.hex`, `input.hex`, `soc_demo_prog.hex`, vector and RNG-trace files (`# spec_rev C`), `revA/`, `revB/` copies |
| `scripts/` | regression and implementation scripts (section 3), `budgets/` (budget calculations) |
| `logs/<area>/` | logs of every run (`cpu`, `tpu`, `soc`, `sw`, `doc`, `smoke`) |
| `reports/sw/`, `reports/fpga/` | accuracy / seed / error-model reports; implementation reports |
| `reports/article/`, `reports/engineering/`, `reports/figures/` | article, engineering report, this manual, figure scripts |
| `releases/` | immutable release baselines (created by the manager with `scripts/make_release.sh`) |

Build products (`sim/**/build/`, `*.vvp`, `*.vcd`) are git-ignored; the bitstream is a build product.

---

## 3. Reproducing the results

### 3.1 Environment
Tools (versions in `management/TOOLCHAIN.md`): Python 3.13 venv `.venv` with numpy, scikit-learn,
matplotlib, pytest, `yowasp-yosys` (Yosys 0.70), `yowasp-nextpnr-himbaechel-gowin` (nextpnr-0.11.1),
`apycula` (`gowin_pack`, 0.32); Icarus Verilog 12.0, Verilator 5.020 and TeX Live (latexmk,
IEEEtran) on `PATH`.

```bash
cd <repo>
source .venv/bin/activate        # makes yowasp-* and gowin_pack available
```

Every log records the git revision it ran on; a `-dirty` suffix means uncommitted changes were present.
Exit code 0 alone is never a pass: check the decisive lines below.

### 3.2 Commands and expected decisive lines

| # | What | Command (from the repository root unless noted) | Time | Expected decisive line(s) | Log |
|---|---|---|---|---|---|
| 1 | Python unit tests | `cd code/python && ../../.venv/bin/python -m pytest -v tests` | ~30 s | `158 passed` | `logs/sw/pytest_revC.log` |
| 2 | Accuracy study rev C (20-offset ensemble) | `cd code/python && ../../.venv/bin/python -m sctpu.accuracy --spec-rev C --ensemble-size 20` | ~1 min | `int8-vs-EV mismatches=0`; `requirement evidence (mode 2): REQ-AI-004=PASS, REQ-AI-005=PASS, REQ-AI-006=PASS, REQ-AI-009=PASS` (writes `reports/sw/accuracy_revC.json`) | `logs/sw/accuracy_revC.log` |
| 3 | Seed selection on validation data | `cd code/python && ../../.venv/bin/python -m sctpu.seed_select` | ~1 min | `SELECTED: C0`; ranking `['C0', 'C3', 'C4', 'C2', 'C1']` | `logs/sw/seed_selection_revC.log` |
| 4 | Rev A / B / C comparison (test split) | `cd code/python && ../../.venv/bin/python -m sctpu.compare_abc` | ~3 min | `EXIT=0`; identities rev C = rev A (mode 2), rev C = rev B (modes 0/1) asserted; `reports/sw/revABC_comparison.md` table "C vs B, K = 9, p = 0.00151" | `logs/sw/compare_abc.log` |
| 5 | Golden vectors (see warning) | `cd code/python && ../../.venv/bin/python -m sctpu.gen_hex --spec-rev C --out <scratch dir>` | minutes | `CROSSCHECK TOTAL: 593 vectors x 33 fields, mismatches = 0`; `FINAL MISMATCH COUNT (vectors + soc_expected): 0` | `logs/sw/gen_hex.log` |
| 6 | CPU regression (44 programs x 4 bus timings + 2 negative runs) | `bash scripts/sim_cpu.sh` | ~10 s | `# runs: 176 / 176 PASS`; `# aggregate CPI at 0 wait states: 28206 cycles / 6667 instructions = 4.231`; `SIM_CPU: ALL PASSED` | `logs/cpu/sim_cpu_summary.log` |
| 7 | TPU regression (lint, unit TBs, 3 modes, negative runs) | `bash scripts/sim_tpu.sh` (`QUICK=1` skips the 360-vector files) | ~45 min | mode 2: `golden vectors total 474 (+69 clamp re-runs), mismatching inferences 0, mismatching fields 0`; `PASS: D2 PARAMS = 0x03020810`; `PASS: D8 CYCLES = 2928 ...`; `SIM_TPU ALL PASSED (revision ...)` | `logs/tpu/sim_tpu_console.log` |
| 8 | SoC regression (demo, 44 CPU programs on the SoC, fabric TB, 4 negative runs) | `bash scripts/sim_soc.sh` | ~2 min | `PASS: D1 TOHOST = 1 ... cycle 5441`; `PASS: D2 ... RESULT ... = golden class 7`; `PASS: D5 ... 0x37 0x0a = "7\n"`; `PASS: D6 CYCLES stored at 0x0E00 = 2928`; `# CPU tests on the SoC: 44 / 44 PASS`; `SIM_SOC ALL PASSED (revision ...)` | `logs/soc/sim_soc_console.log`, `logs/soc/tb_soc_demo.log` |
| 9 | SoC synthesis, P&R (2 flows x 3 seeds), pins, bitstream | `bash scripts/synth_soc.sh` (`REPORT_ONLY=1` rebuilds the tables from existing logs) | ~45 min, single thread | `SYNTH_SOC: PASS (worst nwl seed 2, 47.46 MHz)`; `PACK_EXIT=0`; utilisation LUT4 5628 (65 %); file `sim/soc/build/soc_top.fs`, 3556680 bytes | `logs/soc/synth_soc_console.log`, `reports/fpga/soc/soc_impl.md`, `logs/soc/pack.log` |
| 10 | TPU variant study (IL 4/8/16, modes 0/1/2) | `bash scripts/synth_tpu_variants.sh` (e.g. `VARIANTS="il8_m2" SEEDS="1 2 3" bash ...`) | hours | table in `reports/fpga/tpu/variants.md` (IL 16: `Unable to find legal placement`) | `logs/tpu/synth_*.log`, `pnr_*.log` |
| 11 | CPU stand-alone synthesis | `bash scripts/synth_cpu.sh` | ~15 min | seeds `62.46 / 53.26 / 55.74 MHz` | `reports/fpga/cpu/cpu_synth_pnr.txt` |
| 12 | Toolchain smoke test | `bash scripts/smoke_fpga.sh` | minutes | known-answer counter; `TEST PASSED`, negative run fails | `logs/smoke/fpga_summary.log` |
| 13 | Budget calculations | `.venv/bin/python scripts/budgets/latency_budget.py` (and `lfsr_rules_revC.py`, `stats_budget.py`, `achieved_vs_budget.py`) | s | e.g. known-answer `N(8) = 2969 PASS`; rev C `R1 satisfied`, `R2 satisfied`, min lag 321 | `scripts/budgets/logs/*.log` |
| 14 | Figures | `.venv/bin/python reports/figures/article_figures.py` | s | `wrote .../article_acc_vs_k.pdf`, `article_rms_vs_k.pdf`, `article_revBC.pdf`; prints every plotted value | `logs/doc/article_figures_revC.log` |
| 15 | Article | `cd reports/article && latexmk -pdf -interaction=nonstopmode -halt-on-error main.tex` | s | `Output written on main.pdf (8 pages ...)`; no `undefined` / `Overfull` in `main.log` | `logs/doc/article_latex_revC.log` |
| 16 | Engineering report | `cd reports/engineering && latexmk -pdf -interaction=nonstopmode -halt-on-error main.tex` | s | `Output written on main.pdf (... pages ...)`; no `undefined` / `Overfull` | `logs/doc/report_latex.log` |

Warnings:
- `sctpu.gen_hex` without `--out` **overwrites the tracked golden data in `sim/data/`**; write to a
  scratch directory and compare (`diff -r`), as the software-engineer did
  (`logs/sw/gen_hex_revB_regen_check.log`). The same applies to `sctpu.train`, which re-creates the
  model parameters (reproducibility check: `logs/sw/train_reproducibility.log`, `reproducible: True`).
- The simulation scripts check the header `# spec_rev C` of every vector/trace file. Data generated for
  another revision is rejected on purpose (`SPEC_REV` selects the expected revision; rev B data is in
  `sim/data/revB/`).
- Rerunning P&R overwrites the logs that the reports quote. Commit or copy them first if you want to
  compare.

---

## 4. Register map quick reference

### Memory map
| Base | Size | Slave |
|---|---|---|
| `0x0000_0000` | 4 KiB | RAM (program + data), reset PC = 0 |
| `0x1000_0000` | 0x20 | peripherals |
| `0x2000_0000` | 4 KiB | SC-TPU |
| other | — | reads 0, writes ignored, sticky `bus_err` (no hang) |

### Peripherals (`0x1000_0000`)
| Offset | Name | Access | Bits |
|---|---|---|---|
| 0x00 | LED | RW | [5:0], 1 = LED lit (pins active-low; inverted in the top) |
| 0x04 | UART_TX | W | [7:0] byte; ignored while busy |
| 0x08 | UART_STATUS | R | [0] tx_busy |
| 0x0C | CYCLE | R | 32-bit cycle counter since reset |
| 0x10 | TOHOST | RW | test mailbox: 1 = pass |

### SC-TPU (`0x2000_0000`)
| Offset | Name | Access | Bits / content |
|---|---|---|---|
| 0x000 | CTRL | W | [0] START (ignored while BUSY) |
| 0x004 | STATUS | R | [0] BUSY, [1] DONE |
| 0x008 | CONFIG | RW | [3:0] LOG2_L = K (reset 8, clamped 4..10), [6:4] ACT_SHIFT (reset 0) |
| 0x00C | RESULT | R | [3:0] class |
| 0x010 | CYCLES | R | busy cycles of the last inference (= 10·2^K + 368) |
| 0x014 | PARAMS | R | NL, IL, RNG_MODE, version: `0x0302_0810` in the release build |
| 0x040–0x07F | INPUT[0..63] | RW | one 8-bit code per byte, code = 128 + value·128 |
| 0x080–0x0BF | SCORE[0..15] | R | signed 32-bit per output lane |
| 0x0C0–0x0CF | HIDDEN[0..15] | R | one code per byte |
| 0x100–0x17F | BIAS[0..31] | RW | [15:0] signed (units 1/128), word 16·(layer−1) + neuron |
| 0x800–0xFFF | WEIGHT RAM | RW | 2 KiB, layout in ARCHITECTURE.md 5.5 |

Programming sequence for one inference: write the 16 INPUT words, write CONFIG, write CTRL = 1, poll
STATUS until bit 1 (DONE) is set, read RESULT (and CYCLES). Writes while BUSY are ignored; reads of the
buffers while BUSY may stall for up to ~35 cycles.

---

## 5. Programming the board yourself (NOT done in this project)

**This was not done in the project.** No board was connected, no bitstream was loaded and nothing on this
page has been tried on hardware. Loading a bitstream is your decision and at your own risk. The
pin assignment rests partly on an assumption: which of pins 3 / 4 is the button labelled S1 is not
confirmed by a source available to the project (the design uses pin 3 as reset; the other button is
unused). Both are push-buttons with pull-ups, so a swap only changes which button resets the design.

1. Rebuild and check the bitstream (row 9 of section 3.2). Its sha256 in the project run was
   `152d3c6dada6338e0b98a8fc19557ec95f4e40479e4f264411c72caa85b76258` (`logs/soc/pack.log`).
2. Install `openFPGALoader` on the host (it is not part of the project tool set).
3. Load into the FPGA's volatile configuration SRAM (lost at power-off; the board's flash is untouched):

   ```bash
   openFPGALoader -b tangnano9k sim/soc/build/soc_top.fs
   ```

   openFPGALoader can also write the external flash (option `-f`), which makes the design persistent
   across power cycles. The project gives no procedure for that and does not recommend it for a first
   test.
4. Open a serial terminal on the board's USB serial port at **115200 baud, 8N1, no flow control**, then
   press the reset button. Expected (from simulation): the terminal shows `7` followed by a newline;
   LEDs on pins 10, 11, 13 light up. The demo runs once per reset and then idles.
5. If you want to record the result as evidence, follow the physical validation plan in the engineering
   report (section "Physical validation plan"): it lists what to measure, with which equipment and
   against which requirement. Hardware results would be the project's first MEASUREMENTs.

---

## 6. Troubleshooting

| Symptom | Likely cause / action |
|---|---|
| `yowasp-yosys: command not found` | venv not activated: `source .venv/bin/activate`. The first call of a YoWASP tool compiles its WebAssembly and can take minutes. |
| P&R very slow or `Unable to find legal placement` | expected for dense variants (IL 16 at 73–77 % LUT4); the SoC at 65 % places in ~4–5 min per seed. Use `--threads 1` as the scripts do on a shared machine. |
| A simulation script stops at the `spec_rev guard` | vector/trace files in `sim/data` are not `# spec_rev C` (e.g. regenerated for another revision). Restore them from git or set `SPEC_REV` consistently. |
| A script dies with a syntax error at its last step | it was edited while running (bash reads scripts incrementally). Re-run it after the edit. |
| `sim_tpu.sh` takes very long | the three 360-vector files take ~7 min each in Icarus; `QUICK=1` skips them (not a full regression). |
| Log revision stamp ends in `-dirty` | the tree had uncommitted changes; commit and re-run if the log is to be evidence of a clean revision. |
| Numbers differ from the reports after re-running | check that weights were not re-trained (`retrained: false` in the JSON), that the spec revision matches, and the git revision in the log header. |
| LaTeX: `IEEEtran.cls not found` | install the TeX Live publishers collection (`texlive-publishers`). |
| openFPGALoader cannot open the cable | USB permissions (udev rules) or a charge-only cable; try another cable / port. |
| Board: no UART text | terminal opened after the demo ran (it runs once, ~0.2 ms after reset): open the terminal first, then press reset; wrong serial port if several appear; wrong baud rate. |
| Board: all LEDs off | bitstream not loaded, reset button held, or the button on pin 3 is not the one you think (see section 5). |
| Board: several `7` lines per press | button bounce (there is no debouncer; each bounce is a reset). Harmless. |
