catuta0/tpu-e-cpu/tests/smoke/manager_latex/page.tex

\documentclass{article}
\begin{document}
Manager LaTeX smoke test. Known answer: $2^{10} = 1024$.
\end{document}
