catuta0/tpu-e-cpu/reports/review/build/REV-01a/mut/cpu_mutation_results.txt

C01 | SRA/SRAI fill with 0 (SRA behaves as SRL) | KILLED; RUNS 140/176 PASS; failing tests (9): dir_shifts rand_00 rand_04 rand_05 rand_10 rand_11 rand_15 rand_17 ...
C02 | SRA sign fill only on 4-bit steps, 0 on 1-bit steps | KILLED; RUNS 148/176 PASS; failing tests (7): dir_shifts rand_00 rand_04 rand_11 rand_15 rand_17 rand_18
C03 | JALR target bit 0 treated as misaligned (bit 0 not cleared) | KILLED; RUNS 124/176 PASS; failing tests (13): dir_jumps rand_02 rand_03 rand_05 rand_06 rand_07 rand_09 rand_10 ...
C04 | BLTU/BGEU use the signed comparison | KILLED; RUNS 120/176 PASS; failing tests (14): dir_branches rand_00 rand_01 rand_02 rand_06 rand_07 rand_08 rand_10 ...
C05 | SB byte enable: lanes 1 and 2 swapped | KILLED; RUNS 92/176 PASS; failing tests (21): dir_stores rand_00 rand_01 rand_02 rand_03 rand_04 rand_05 rand_06 ...
C06 | load byte lane 1 and 2 swapped | KILLED; RUNS 136/176 PASS; failing tests (10): dir_loads dir_stores rand_00 rand_07 rand_08 rand_09 rand_10 rand_15 ...
C07 | LB zero-extends (byte sign forced 0) | KILLED; RUNS 124/176 PASS; failing tests (13): dir_loads dir_stores rand_03 rand_05 rand_06 rand_07 rand_08 rand_09 ...
C08 | LH sign taken from bit 14 | KILLED; RUNS 140/176 PASS; failing tests (9): dir_loads dir_stores rand_05 rand_07 rand_08 rand_10 rand_14 rand_16 ...
C09 | SLT uses the unsigned flag | KILLED; RUNS 92/176 PASS; failing tests (21): dir_alu_imm dir_alu_reg rand_00 rand_01 rand_02 rand_03 rand_04 rand_05 ...
C10 | x0 writable (rd != 0 guard removed) | KILLED; RUNS 80/176 PASS; failing tests (24): dir_branches dir_jumps dir_loads dir_x0 rand_00 rand_01 rand_02 rand_03 ...
C11 | halfword misalignment at byte offset 3 not detected (only offset 1) | SURVIVED; RUNS 176/176 PASS; failing tests (0): 
C12 | word misalignment at byte offset 1 not detected | SURVIVED; RUNS 176/176 PASS; failing tests (0): 
C13 | FENCE.I (MISC-MEM funct3 001) accepted as NOP | SURVIVED; RUNS 176/176 PASS; failing tests (0): 
C14 | SLLI/SRLI/SRAI funct7 not checked | SURVIVED; RUNS 176/176 PASS; failing tests (0): 
C15 | JALR funct3 not checked | SURVIVED; RUNS 176/176 PASS; failing tests (0): 
C16 | not-taken branch with misaligned target traps | KILLED; RUNS 172/176 PASS; failing tests (1): trap_misaligned_branch
C17 | B-immediate bit 11 taken from ir[31] instead of ir[7] | SURVIVED; RUNS 176/176 PASS; failing tests (0): 
C18 | J-immediate bit 11 taken from ir[31] instead of ir[20] | KILLED; RUNS 168/176 PASS; failing tests (2): dir_loads dir_x0
C19 | J-immediate bits 19:12 replaced by the sign | SURVIVED; RUNS 176/176 PASS; failing tests (0): 
C20 | AUIPC/JAL/branch target uses pc+4 base | KILLED; RUNS 69/176 PASS; failing tests (31): dir_alu_imm dir_alu_reg dir_branches dir_fence_nop dir_jumps dir_loads dir_lui_auipc dir_mmio ...
C21 | store does not retire | KILLED; RUNS 0/176 PASS; failing tests (44): dir_alu_imm dir_alu_reg dir_branches dir_fence_nop dir_jumps dir_loads dir_lui_auipc dir_mmio ...
C22 | FETCH loads ir every cycle (samples rdata before mem_ready) | KILLED; RUNS 44/176 PASS; failing tests (44): dir_alu_imm dir_alu_reg dir_branches dir_fence_nop dir_jumps dir_loads dir_lui_auipc dir_mmio ...
C23 | S-immediate bit 11 taken from ir[30] | KILLED; RUNS 64/176 PASS; failing tests (28): dir_alu_imm dir_alu_reg dir_branches dir_fence_nop dir_jumps dir_loads dir_lui_auipc dir_mmio ...
C24 | I-immediate bit 11 taken from ir[30] (sign ok) | KILLED; RUNS 0/176 PASS; failing tests (44): dir_alu_imm dir_alu_reg dir_branches dir_fence_nop dir_jumps dir_loads dir_lui_auipc dir_mmio ...
C25 | SLTIU compares signed | KILLED; RUNS 112/176 PASS; failing tests (16): dir_alu_imm dir_alu_reg rand_00 rand_01 rand_02 rand_03 rand_06 rand_08 ...
C26 | shift amount uses only imm/rs2 bits [3:0] | KILLED; RUNS 108/176 PASS; failing tests (17): dir_shifts rand_01 rand_03 rand_04 rand_05 rand_06 rand_07 rand_08 ...
C27 | ECALL/EBREAK cause codes swapped | KILLED; RUNS 172/176 PASS; failing tests (1): trap_ecall
C28 | LHU sign-extends | KILLED; RUNS 124/176 PASS; failing tests (13): dir_loads dir_stores rand_00 rand_01 rand_02 rand_04 rand_07 rand_09 ...
C29 | trapping JAL/JALR (misaligned target) still writes rd | SURVIVED; RUNS 176/176 PASS; failing tests (0): 
C30 | CLEAR state does not write the register file (no reset of x1..x31) | SURVIVED; RUNS 176/176 PASS; failing tests (0):
