catuta0/tpu-e-cpu/tests/smoke/manager_latex/page.pdf

Manager LaTeX smoke test. Known answer: 2¹⁰ = 1024.

1
