catuta0/tpu-e-cpu/changes/CR-001.md

# CR-001 — Deterministic (binary) TPU replaces the stochastic TPU as the product design

Status: OPEN (2026-11-04) · Requester: user ("faz o tpu deterministico, ou seja sem bitstreams")
Baseline preserved: stochastic design rev C at git commit d0d6984 (local tag
`sc-tpu-revC`; the proxy refused to push the tag, the commit is on the branch).
The SC-TPU RTL stays untouched in design/rtl/tpu/ as the comparison design; the
new design lives in design/rtl/tpu_det/.

## Motivation
User decision. Engineering note: the SC-TPU needs 10*2^K+368 cycles (2928 at K=8)
and is approximate (94.4 % vs 95.0 % exact, SIMULATION); an exact int8 datapath
with the same weights reaches the exact-arithmetic accuracy (95.0 %, already
computed as the "int8 binary" baseline in SW-01a) in ~10^2 cycles.

## Impact analysis
| Area | Impact |
|---|---|
| Requirements | REQ-TPU-* rewritten for rev D (deterministic); REQ-AI accuracy target becomes exact match to the int8 golden model + >= 94 % test accuracy; latency target new; SC requirements move to the "comparison design" group |
| Interfaces | INTERFACES.json rev D: same bus, same memory map and register offsets; CONFIG.LOG2_L reserved; PARAMS new fields; WEIGHT layout changes to input-major (16 bytes per input row) |
| RTL | new design/rtl/tpu_det/ (dt_tpu*); soc_top selects the TPU by parameter (default deterministic); CPU unchanged |
| Tests | new TPU TB + vectors; SoC TB re-run with deterministic TPU; CPU suite unchanged |
| Python | new golden model sctpu/det_model.py (exact int), new gen of weights.hex (new layout), vectors, soc_expected; network NOT retrained (same codes) |
| Resources/timing | 16 multipliers 8x8 signed (DSP MULT9X9/MULT18X18 or LUT) — variant study required |
| Docs | article reframed: deterministic product + stochastic comparison design; engineering report + manual updated |
| Risks | open-source DSP support for GW1N-9C must be smoke-tested first |

## Plan
1. ST-FPGA-02: smoke-test DSP inference (signed 8x8 multiply) through Yosys/nextpnr/gowin_pack.
2. SW-05: exact golden model rev D, vectors, init files (new layout).
3. RTL-DET: deterministic TPU + TB + variants (DSP / LUT / time-multiplexed) + SoC integration + P&R.
4. REQ-03: requirements/budgets rev D. 5. Review of the changed outputs. 6. Docs. 7. Release.
