catuta0/tpu-e-cpu/management/RISKS.md

# Risk register — SC-TPU + RV32I SoC on Tang Nano 9K

Created by systems-engineer in REQ-01 (2026-11-04), input revision `494448a`.
**Updated in REQ-02 (2026-11-04), input revision `1d67c44` (spec rev C, after
RTL-SOC and SW-03).** Shared file: write only with a lock in
`management/locks/RISKS.md.lock`.

Scales: Likelihood L / M / H (low < 20 %, medium 20-60 %, high > 60 %,
ASSUMPTION-based engineering judgement); Impact L (cosmetic / report wording),
M (rework of one block or a requirement weakened), H (a hard constraint or a
headline result fails). "Mitigation status" uses the project status words:
NOT RUN (mitigation not yet executed), PARTIAL (partly executed), PASS
(mitigation executed and effective — on SIMULATION evidence only; no risk is
retired by hardware evidence in this project). "Risk state" (issue 2): OPEN,
REALISED (the risk occurred), MITIGATED (occurred or threatened and the
mitigation is effective), RETIRED (cannot occur any more in this project).
L / I columns give the issue-1 value -> issue-2 value where they changed.
Evidence paths are relative to the repo.

| ID | Risk (cause -> effect) | L | I | Mitigation | Owner | Mitigation status | Risk state (issue 2) | Evidence / trigger |
|---|---|---|---|---|---|---|---|---|
| R-01 | **SC accuracy too low**: stream noise and RNG correlation at the default L = 256 push the bit-exact test accuracy below 90 % (REQ-AI-004) or > 2 pp below EV (REQ-AI-005). Preliminary SIMULATION: mode 1 = 91.1 % at K = 8 (95 % CI ~ +/-3 pp), mode 0 = 65.6 % | M -> L | H | Select RNG mode 2 (done, ADR-008/010); noise-aware QAT (done, qat_noise); ACT_SHIFT tuning on the validation split (done, s = 0); seed ensembles and CIs (done); fall-back K = 9 default not needed | software-engineer | PASS | MITIGATED (partly realised in rev B: K = 9 89.7 %, see R-02) | reports/sw/accuracy_revC.json: mode 2 K = 8 94.4 % (340/360, Wilson 91.6-96.4 %), EV 95.0 %, K_op = 8, ensemble 92.8 +/- 1.4 % (SIMULATION). Residual: the CI lower bound is 1.6 pp above the 90 % threshold |
| R-02 | **LFSR correlation**: all LFSRs share one polynomial, so all streams are time-shifted copies of one m-sequence; mode 0 cross-lane correlation 1.0, mode 1 up to 0.52; badly chosen seeds make lanes' operand-pair streams translates of each other -> coherent (non-averaging) errors, accuracy loss (R-01) | H (modes 0/1) / L (mode 2) -> L (rev C mode 2) | M -> H (rev B showed a headline-result impact) | Issue 1 proposed "choose mode-2 seeds by maximum pairwise phase distance" — **this mitigation was wrong**: it produced rev B (ADR-008). Effective mitigation (ADR-009/010): seed rules R1 (no translated operand-pair streams) + R2 (no direct/swapped shared-bit lags), candidates selected by a pre-registered protocol on the validation split only, test split evaluated once afterwards; two independent R1/R2 implementations | systems-engineer + software-engineer | PASS (rev C) | **REALISED in rev B** (R1 violated on 28/28 lane pairs; K = 9 accuracy 89.7 % vs 94.4 %, McNemar p = 0.0015, SW-02/ADR-009); **MITIGATED in rev C** (R1/R2 satisfied, min lag 321 stream cycles, K = 8/9/10 = 94.4/94.4/95.3 %) | reports/sw/revA_vs_revB.md, reports/sw/seed_selection_revC.md, scripts/budgets/logs/lfsr_rules_revC.log. Residual (accepted): modes 0/1 pair violates R2 by self-swap (study modes only, ADR-010 D-B); at K = 10 each generator re-uses its own bit sequence shifted by 1 bit after 8192 stream cycles (BUDGETS.md 9.1, no measured penalty); single polynomial kept |
| R-03 | **Resource overflow**: the SC MAC lane costs ~22 LUT (tool estimate) instead of ~9 (ADR-001); budget 66 % nominal / 78 % worst-case LUT vs 85 % limit; IL = 16 does not fit (94.5 %); storage in FFs or an FF register file would overflow | M -> L | H | Track RTL synthesis against BUDGETS.md 1.4 (done); storage in LUT-RAM / BSRAM (done; regfile in BSRAM); fall-back IL = 4 not needed | fpga-engineer | PASS | RETIRED for the frozen design | reports/fpga/soc/soc_impl.md: LUT4 5628 / 8640 (65.1 %), DFF 2803 (43.3 %), BSRAM 5 / 26 (SIMULATION of P&R). Residual for any change: block-level budgets were off by +20 % (TPU) / -51 % (CPU), see R-16 |
| R-04 | **Timing closure**: congestion at ~66 % utilisation adds routing delay; an unpipelined post-processing datapath could exceed the 33.67 ns budget | L | M | Post-processing pipelined in 2 stages (done); 3 seeds (done); release flow `-nowidelut` (+4.7 MHz worst seed, ADR-011) | fpga-engineer | PASS | MITIGATED | logs/soc/pnr_nwl_s{1,2,3}.log: worst 47.46 MHz vs 29.7 MHz (slack 12.6 ns, SIMULATION STA). Note: the critical path is the CPU (ir -> decoder/FSM -> ALU -> pc, 21.07 ns), not the predicted SC MAC path (BUDGETS.md 5). Timing model not silicon-validated (R-05) |
| R-05 | **Open-toolchain maturity for GW1N-9C**: BSRAM inference / init, LUT-RAM mapping, reverse-engineered timing model not silicon-validated, gowin_pack bitstream correctness unverifiable without hardware; nextpnr placer stalls or fails on dense designs | M | H | BSRAM / RAM16 mapping checked in the routed netlist (done: 5 BSRAM, 3 with non-zero INIT); 10 % Fmax margin (done, +60 %); tool versions recorded (done); post-synthesis simulation with Gowin cell models — NOT RUN (yowasp-yosys has only black-box BSRAM stubs) | fpga-engineer | PARTIAL | OPEN | logs/soc/bsram_init.log, logs/soc/pack.log (bitstream built, never programmed). New evidence: the IL = 16 TPU found **no legal placement at 73-77 % LUT4** (ALU-heavy, RTL-TPU), i.e. the practical placement limit for ALU-heavy designs can be below the 85 % rule; the release SoC at 65 % placed on all seeds |
| R-06 | **Bit-exactness drift between model and RTL**: spec ambiguities, off-by-one in LFSR advance / reload, floor vs truncation, intermediate overflow -> SCORE/HIDDEN mismatches, accuracy not transferable | M -> L | H | Golden model single reference; per-cycle LFSR trace (done); corner vectors (done); full vector sets per mode (done); A.2 clarifications (done); `# spec_rev` guard on every vector/trace file (done, RTL-SOC) | software-engineer + fpga-engineer | PASS | MITIGATED (simulation level) | logs/tpu/tb_sc_tpu_mode{0,1,2}.log: 1454 golden inferences + 239 clamp re-runs rev C, 0 mismatching fields; SoC demo bit-exact (tb_soc D3). Residual: gate-level equivalence NOT RUN (R-05) |
| R-07 | **Unverifiable datasheet values** (network policy blocks gowinsemi / sipeed download hosts): BSRAM modes/widths (S-006..S-009), core voltage, package I/O, oscillator values remain ASSUMPTION | M | L | Device totals SOURCE via chip database and Sipeed wiki; remaining values labelled ASSUMPTION; user asked at G1 to allow the hosts (OD-16) | systems-engineer | PARTIAL | OPEN (user decision pending) | management/SOURCES.md; BSRAM 512x32 SDP/SP modes used by the RTL were accepted by the open flow (SIMULATION, not a datasheet confirmation) |
| R-08 | **No hardware validation**: all results are simulation and P&R tool estimates; board-level behaviour (real timing, BSRAM init, pinout, S1/S2 mapping, UART direction, power) unproven | H (certain by scope) | M | Physical validation plan (REQ-VER-009); conservative margins; explicit labelling ("simulation is not test") | documentation-engineer + systems-engineer | NOT RUN (plan not yet written) | OPEN (accepted by scope) | REQ-VER-009 |
| R-09 | **Top-level naming / pin ambiguity**: reset port name and S1/S2 <-> pin 3/4 mapping | H -> L | L | P&R fails loudly on unconstrained I/O; pin report checks every port | manager + fpga-engineer | PARTIAL | Name part RETIRED — the REQ-01 finding was wrong (CST names the port `btn_rst_n` since 199a3dc); S1 = pin 3 still ASSUMPTION | logs/soc/pins.log: 10 IOs on CST pins, btn_rst_n pin 3 |
| R-10 | **Statistical resolution of accuracy claims**: n = 360 gives a 95 % CI half-width of 2.3-3.1 pp; differences below ~3 pp are not significant -> over-claiming in the article | H -> M | M | Wilson CIs (done in SW-02/03), seed ensembles (done), paired exact McNemar for rev/mode comparisons (done); article wording to be checked in DOC-02 / REV-01 | software-engineer + documentation-engineer | PARTIAL | OPEN | reports/sw/seed_selection_revC.md (C0 vs C3/C4 not significant), reports/sw/revABC_comparison.md |
| R-11 | **Latency above budget**: O_TILE / post-processing assumptions too optimistic -> CYCLES > 1.10 x N(K) (REQ-TIM-004) | M -> L | L | RTL documents the cycle formula; CYCLES checked in simulation (done) | fpga-engineer | PASS | RETIRED for the frozen design | CYCLES = 10*2^K + 368 < 10*2^K + 409 for every K (SIMULATION, logs/tpu/tb_sc_tpu_mode2.log D8; BUDGETS.md 3) |
| R-12 | **Weight-RAM / buffer port sharing**: CPU reads while BUSY share the TPU-owned memory ports -> stalls or wrong read data | M -> L | L | A.2: reads while BUSY allowed and return current contents (done); RTL stalls the read until the port is free and returns correct data (SIMULATION, tb_sc_tpu D7) | manager + fpga-engineer | PARTIAL | OPEN — residual requirement conflict: stall up to 35 cycles vs the 4-cycle slave-latency bound of REQ-SYS-007 (OD-R2-1) | management/handoffs/fpga-engineer/RTL-TPU.md; requirements/REQUIREMENTS.md REQ-SYS-007 note |
| R-13 | **Repository bloat**: budget/P&R build products committed in WIP commits | H -> L | L | `scripts/budgets/build/` and `sim/**/build/` git-ignored and untracked (ADR-007) | manager | PASS | MITIGATED (history still contains the old blobs) | .gitignore |
| R-14 | **Optimistic / unresolved seed selection** (new, issue 2): the 288 validation images were part of the final training set, so validation accuracies (97-99 %) are optimistic; the protocol picks C0 over C3 by 2 images (not significant) -> the "best seed" claim could be over-stated | M | L | Selection rule fixed in advance (ADR-009); only the ranking used; test split evaluated once afterwards; caveat recorded in ADR-010 and SW-03; article must not claim C0 is significantly better than C3/C4 | software-engineer + documentation-engineer | PARTIAL (article wording not yet checked) | OPEN | reports/sw/seed_selection_revC.md |
| R-15 | **Revision mix-up** (new, issue 2): three seed revisions (A, B, C) exist, rev C mode 2 = rev A mode 2 but modes 0/1 = rev B; superseded rev B vectors, logs or article numbers could be mixed with rev C results | M | M | PARAMS.version 0x03 (REQ-TPU-003); `# spec_rev C` guard in every vector/trace file and in sim scripts (RTL-SOC); requirements and budgets re-baselined on rev C (REQ-02); reviewer to check article/report numbers against rev C sources | manager + documentation-engineer | PARTIAL | OPEN | logs/tpu/sim_tpu_console.log (`spec_rev guard`), REQUIREMENTS.md change history |
| R-16 | **Budget-method weakness** (new, issue 2): block-level LUT budgets were off by +20 % (TPU, un-benchmarked control/post-processing +94 %) and -51 % (CPU proxy); the SoC total matched only by compensation -> a future change (e.g. double-buffered weights, IL change) budgeted with the same method could overflow | M | M | Re-calibrate per-block costs from the RTL (hierarchical / per-module synthesis) before budgeting any change; use the achieved per-lane cost 14.4 LUT instead of the bench 22 LUT | systems-engineer | NOT RUN | OPEN (no change planned for V1) | requirements/BUDGETS.md 1.4 notes T and C, scripts/budgets/logs/achieved_vs_budget.log |

## Change history
| Date | Task | Change |
|---|---|---|
| 2026-11-04 | REQ-01 | Created R-01..R-13 |
| 2026-11-04 | REQ-02 | Added "Risk state" column; R-02 REALISED in rev B / MITIGATED in rev C (issue-1 mitigation proposal recorded as wrong); R-01, R-04, R-06, R-13 MITIGATED; R-03, R-11 RETIRED for the frozen design; R-09 name part retired (REQ-01 finding wrong); R-05 new placement-limit evidence; R-12 residual OD-R2-1; new R-14 (seed-selection optimism), R-15 (revision mix-up), R-16 (budget method) |
