catuta0/tpu-e-cpu/reports/figures/article_acc_vs_k.pdf

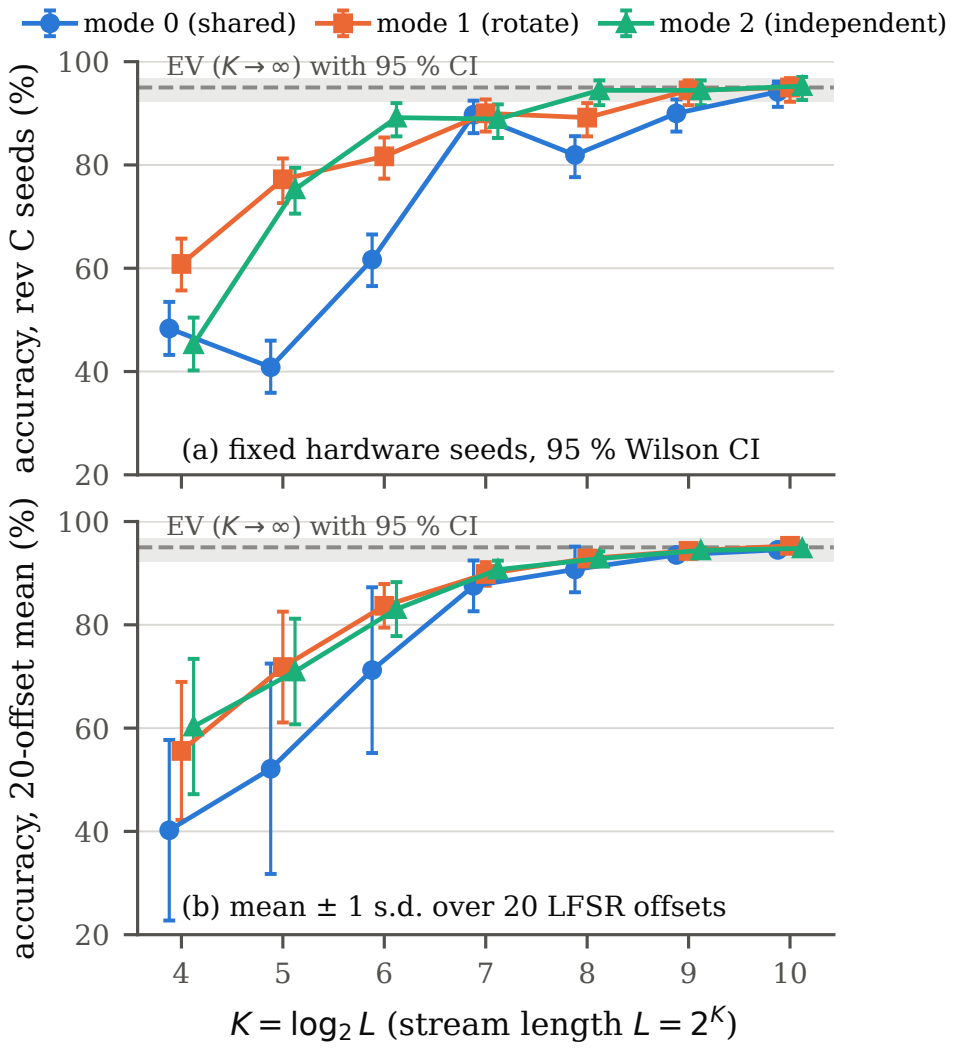
[picture p9: page 1]
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

EV (K → ∞) with 95 % CI

accuracy, rev C seeds (%)

(a) fixed hardware seeds, 95 % Wilson CI

(b) mean ± 1 s.d. over 20 LFSR offsets
