catuta0/tpu-e-cpu/reports/figures/article_rms_vs_k.pdf

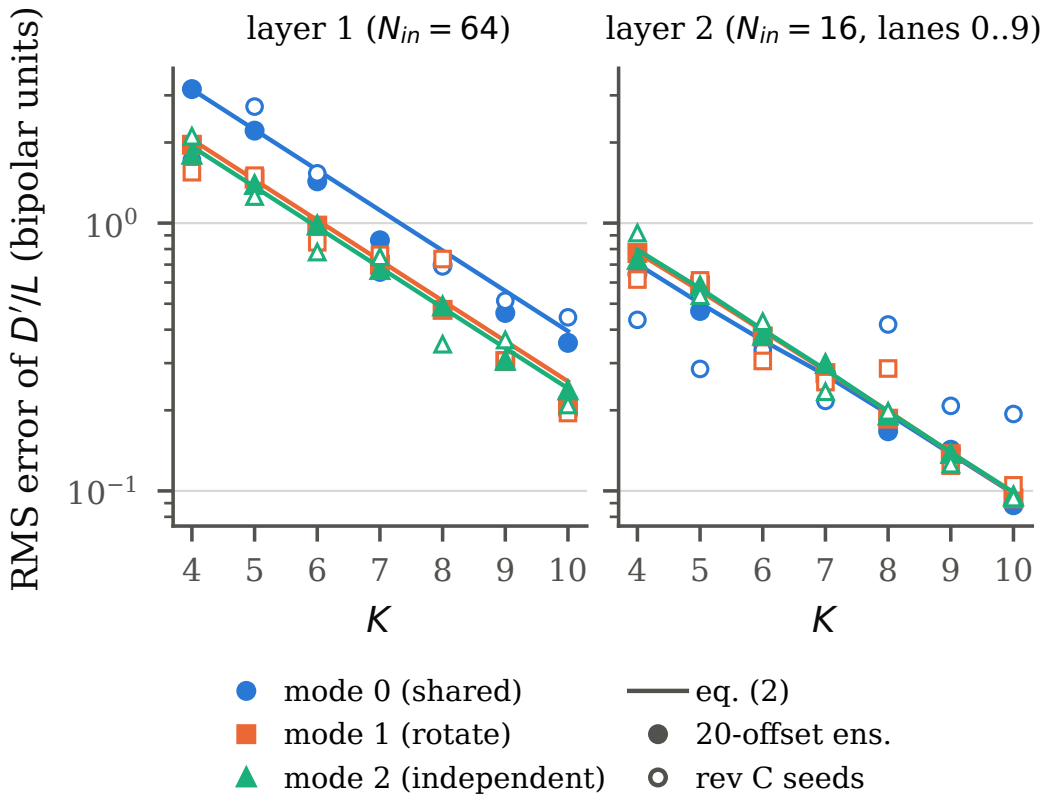
[picture p10: page 1]
/L (bipolar u; nits); layer 1 (Nin = 64); mode 0 (shared) mode 1 (rotate) mode 2 (independent); eq. (2) 20-offset ens. rev C seeds

layer 2 (Nin = 16, lanes 0..9)

MS error of D
