catuta0/tpu-e-cpu/reports/sw/fig_accuracy_vs_K.pdf

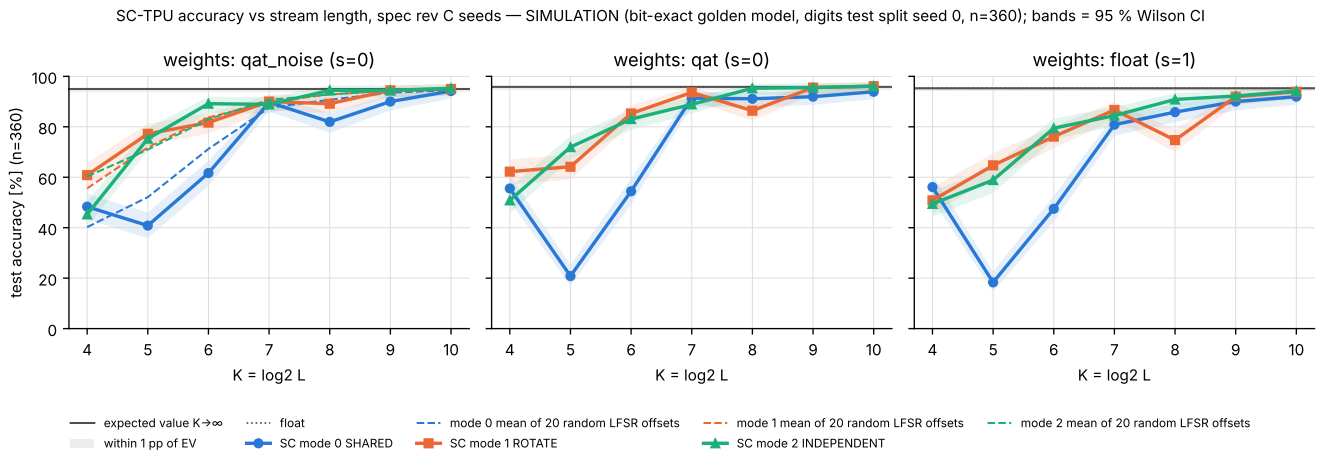
[picture p11: page 1]
K = log2 L; test accuracy [%] (n=360); weights: qat_noise (s=0); weights: qat (s=0); weights: float (s=1); expected value K→∞

SC-TPU accuracy vs stream length, spec rev C seeds — SIMULATION (bit-exact golden model, digits test split seed 0, n=360); bands = 95 % Wilson CI

float
SC mode 0 SHARED

mode 0 mean of 20 random LFSR offsets
SC mode 1 ROTATE

mode 1 mean of 20 random LFSR offsets
SC mode 2 INDEPENDENT

mode 2 mean of 20 random LFSR offsets

within 1 pp of EV
