catuta0/tpu-e-cpu/reports/sw/fig_revABC_accuracy_vs_K.pdf

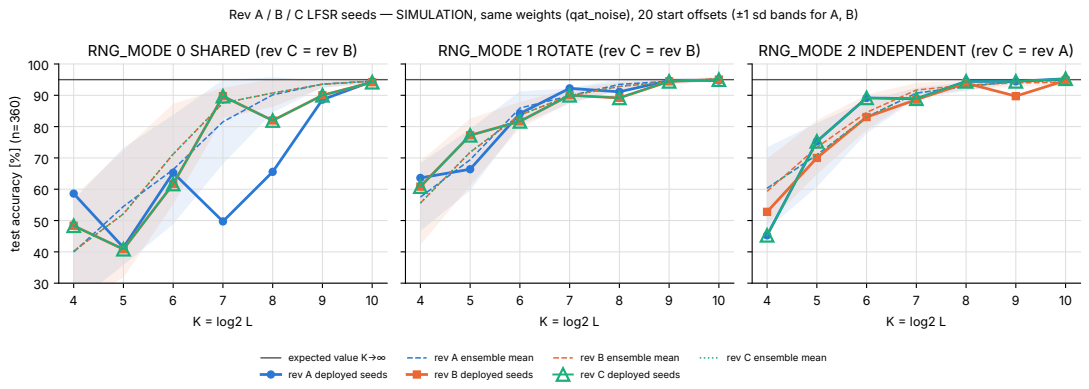
[picture p12: page 1]
K = log2 L; test accuracy [%] (n=360)

Rev A / B / C LFSR seeds — SIMULATION, same weights (qat_noise), 20 start offsets (±1 sd bands for A, B)

RNG_MODE 0 SHARED (rev C = rev B)

RNG_MODE 1 ROTATE (rev C = rev B)

RNG_MODE 2 INDEPENDENT (rev C = rev A)

expected value K→∞
rev A deployed seeds

rev A ensemble mean
rev B deployed seeds

rev B ensemble mean
rev C deployed seeds

rev C ensemble mean
