catuta0/tpu-e-cpu/reports/sw/fig_rms_error_vs_K.pdf

# layer 1 (64 inputs)

# layer 2 (16 inputs, lanes 0..9)

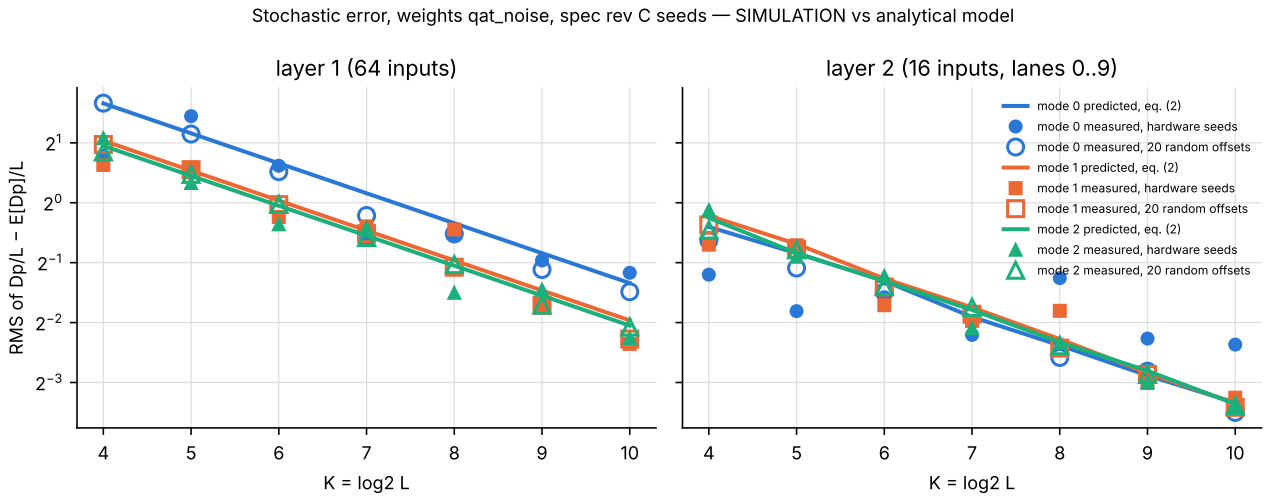
[picture p13: page 1]
K = log2 L

Stochastic error, weights qat_noise, spec rev C seeds — SIMULATION vs analytical model

mode 0 predicted, eq. (2)

mode 0 measured, hardware seeds
mode 0 measured, 20 random offsets
mode 1 predicted, eq. (2)

RMS of Dp/L − E[Dp]/L

mode 1 measured, hardware seeds
mode 1 measured, 20 random offsets
mode 2 predicted, eq. (2)

mode 2 measured, hardware seeds
mode 2 measured, 20 random offsets
