catuta0/tpu-e-cpu/reports/sw/fig_revA_vs_revB.pdf

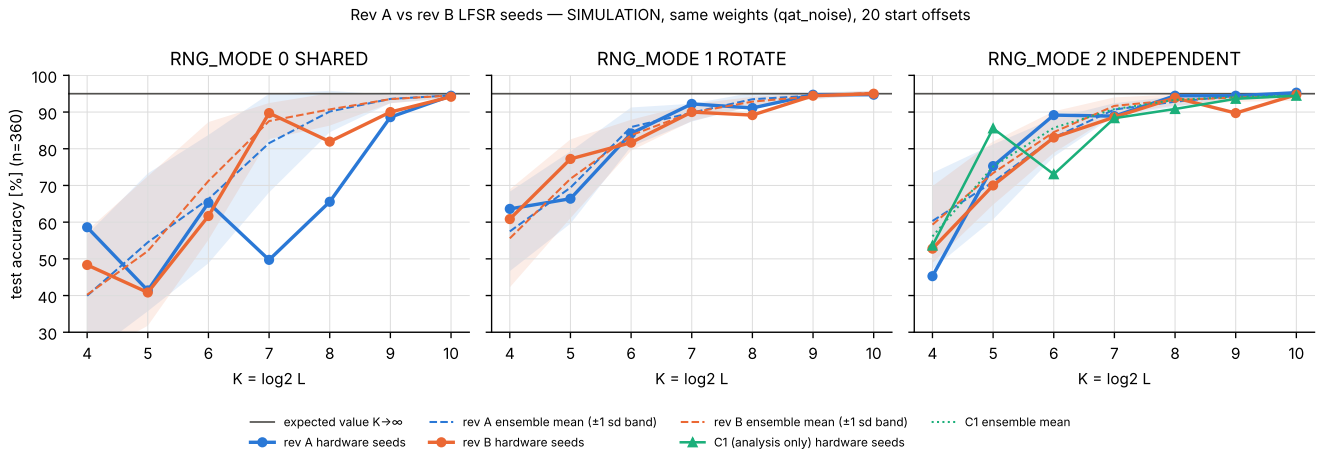
[picture p14: page 1]
K = log2 L; test accuracy [%] (n=360); RNG_MODE 0 SHARED; RNG_MODE 1 ROTATE; RNG_MODE 2 INDEPENDENT; expected value K→∞; C1 ensemble mean

Rev A vs rev B LFSR seeds — SIMULATION, same weights (qat_noise), 20 start offsets

rev A ensemble mean (±1 sd band)

rev B ensemble mean (±1 sd band)
C1 (analysis only) hardware seeds

rev A hardware seeds

rev B hardware seeds
