catuta0/tpu-e-cpu/reports/sw/fig_s_sweep.pdf

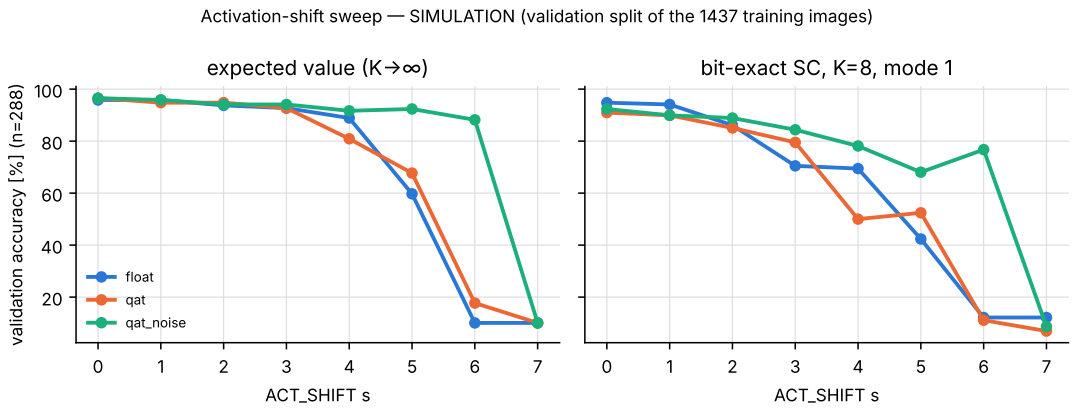
[picture p15: page 1]
ACT_SHIFT s; validation accuracy [%] (n=288); expected value (K→∞); float; qat; qat_noise

Activation-shift sweep — SIMULATION (validation split of the 1437 training images)

bit-exact SC, K=8, mode 1
