catuta0/tpu-e-cpu/(commit log)

2026-11-04 Gate log, task board, smoke results so far
2026-11-04 SW-01b assembler/ISS/44 CPU tests PASS (93 unit tests); spec rev A.1 clarifications (ADR-006)
2026-11-04 Task board / state update
2026-11-04 Task board/state for CR-001
